Siddhu-123/ai-designed-3d-glasses-clipon/prompts/original_prompts.md

# My original prompts (curated)

Every prompt I typed for this project, oldest first, numbered as in my private log. Two parallel sessions received the same prompt early on; duplicates are merged. Prompts for an unrelated side project are left out, local paths are shortened and strong language is masked. Nothing else is edited, typos included.

**[1]** `2026-10-01T13:39`

> use blender and open the refined.blend file, you will see three pictures of the eyewear, and also a wire mesh. I just want to create that glasses in 3D with proper curvature and all, so that I can create a 3D model of my glasses exactly like my glasses. Use the images for proper alignment and don't f*** up my original model. I also have a mobile LiDAR scanned model of my glasses front, so yeah, that's what I want it to be polished and well structured I want the structure to be spot on. If the plane is flat in the images, I want the 3D model also have the place flat, so do whatever you can, but do best quality. Also, do it with less usage. This is the whole message I am going to give you. I want you to do complete it in this one message

**[2]** `2026-10-01T14:06`

> the bezier curve is what i manually created

**[3]** `2026-10-01T14:29`

> no i dont want you to build the glasses from the lidar scan i want you to create the glasses from the images from all three axes

**[4]** `2026-10-01T15:16`

> so how hard is it to align the glasses with the images? you can clearly see how much difference is there so why cant you sculpt it properly

**[5]** `2026-10-01T15:58`

> you're almost there continue optimising

**[6]** `2026-10-01T16:22`

> what is the alignment accuracy ? i feel like we are almost 80% so do that and do even more finetuning and bring the glasses 100% . something to assume is my photo is not 100% 90deg accurate when taking the images of the glasses so you dont need to think that you are not able to match it. you can alter the image angle such that the image is aligned to the model cause it can be 1 or 2 degrees off. my concern is the front of the glasses i want to create attachments for it so i need that accuracy.

**[7]** `2026-10-01T16:46`

> remove unnecessary files in the folder so much c**p

**[8]** `2026-10-01T16:58`

> see the screenshots pasted with highlighting adjustments

**[9]** `2026-10-01T17:28`

> ok this is good now remove all other files or backups

**[10]** `2026-10-02T08:34`

> i am happy with the glasses_refined.blend but i want a 3d printing ready format export so i see if it is coming the way i wanted also how do we know if we scaled it correctly with the real work size? and i still need to create an attachment to it for making my 3d glasses

**[11]** `2026-10-02T08:49`

> the inside plastic is chapped different compared to the outside looksso i think we need to manually design it "…/dev/blender_ai/IMG_7899.JPG" ,"…/dev/blender_ai/IMG_7900.JPG" i sent the filamnets indide the 3d glasses an the size comparison. also note the white red attachments on the filamnets are my experiment using coke tin cans so i can attach the filament directly on my glasses using aluminium bending flexibility but its spoilling the filament when i use super glu to attach the attachments to the filament so i disgarded the project. s mind the red white thing and dont think its a part of the filament

**[12]** `2026-10-02T09:16`

> "dont put holes  for magnest just put leave it like that i still need to find magnets and their size tells me how much indent is needed to place the magnet and stick it to the frame and cover it with 3d printing (like i will stop the 3d printer at the correct time and place the magnets and let it continue the printing so the magnets stay inside the frame. dont put holes i want a frame that can let me put the filament efforlessly  like it should support indentations inside the frame curvature that support filament to slide in and place the filament ", '…/dev/blender_ai/Screenshot 2026-10-02 at 18.40.57.png'

**[13]** `2026-10-02T09:34`

> so i want to see how to check stress points of the model and if i place the magnets inside the frame can the frame be able to sustain cause we will need to remove as well? so that force should repi my frame due to the magnets so we should see if we can think of all that and choose magnets based on their pull force and where to place them. check for flat surfaces on the frame suggest where to place the magnets and also make sure the frame wont take more space from vision. give me a detailed analysis of  all of this i found this website"https://magnet.com.au/collections/shop?q=magnets" so we can buy magnets and decide what type of magnets we should buy and all. find me the best deal

**[14]** `2026-10-02T09:54`

> did you place this frame on the main glass model and see how much view i am loosing and how thin the frame sides and bottom are getting ? place it on the blender file i will inspect done create another stl wait until i say

**[15]** `2026-10-02T10:17`

> i think you are getting the filament size wrong please cross check and show me if you correctly the dimension correct? because the glasses are correct dimension but the frame looks bigger and the filament cavity is really big than the filament itself so how are we planing to place the filament inside the area we need to place the filament. create a film sheet with its correct dimensions and show me how it fits inside the frame.see these relative size comparison sorry the outline is not good so i sent you the film seperately so see how it compares ith the glasses

**[16]** `2026-10-02T10:24`

> now that you got the film so place that film you generated on to one of the photos i sent "…/dev/blender_ai/IMG_7904.jpg" and check if it did a good job ?

**[17]** `2026-10-02T11:35`

> I found a new 3-D classes frame and bigger lenses, so I also added a 10 cents Australian coin for reference to see the size and measure the millimetre accurate dimensions of the film and the glasses"…/dev/blender_ai/IMG_7905.JPG" redo the 3D frame render, adjust with this new dimensions and give me a STL file and all the analysis of how much like, like, do all the magnet placing part frame correction size correction, all of that, even the perspective correction, everything and give me the blender file so that I can see how it looks from the frame, like when the frame is added, also do the stress testing, what magnet should I put with what length, like what size do all that

**[18]** `2026-10-02T12:12`

> you can omit the old film related stuff

**[19]** `2026-10-02T12:13`

> even the pictures,stls,visualizations all of it remove

**[20]** `2026-10-02T12:16`

> are you sure you removed every thing?, also are you sure the real outline of the film and the shape you showed in this comparison correct? are we comparing both the films? are considering the extra indent too

**[21]** `2026-10-02T12:27`

> why the template we are not cutting the film we will use the existing film as it is in the frame so design the frame accordingly

**[22]** `2026-10-02T13:03`

> I didn't ask you to remove the V2 version, which with cutting the film simulation, because this thing I think it's protruding so much into the glasses that it's disturbing to see. Also, I already shared you how this 3D glasses structure works. I think you have that reference as well. see, analyse that and then tell me if it really extrudes that much"…/dev/blender_ai/IMG_7905.JPG"

**[23]** `2026-10-02T13:26`

> Can you give me a range or approximation of the magnet stats so I can start searching for magnets and find better deals? Also, I only want to buy one size of magnet and place it on the frame text me that one magnet size that has better pull strength, whatever we need, like that

**[26]** `2026-10-02T14:03`

> organize the repo its so confusing which is which

**[28]** `2026-10-02T15:15`

> is the final frame design ready for 3d printing did you satify all my needs?

**[30]** `2026-10-02T15:32`

> i bought the 4mm x 1mm with a 172g of pull force

**[32]** `2026-10-02T15:39`

> in other folders, there are so many other comparison type of PNGs. What are they, and then why are they not there in this new flash 4X one folder? Generate them and I don't want to cut the film that much because it is a really big one, and I don't want to limit the size it is giving me to utilise, it's okay even if it is bigger than the lens, but it shouldn't be uncomfortable for my nose. That's all I'm trying to see

**[34]** `2026-10-02T16:00`

> …/dev/blender_ai/clipon_v2/flush_4x1/clipon_v2_flush_4x1_layout.png

**[36]** `2026-10-02T16:26`

> place the magnets in places with better padding i think you have more space if you move it a bit"…/dev/blender_ai/clipon_v2/strong_4x1/clipon_v2_strong_4x1_layout.png" i think this we can do, and also on the underside of the frame we can add the base cause any way we cant see beyond the glass frame so the scribbled area can be closed and the film can be even secured and more strength can be added.

**[38]** `2026-10-02T16:51`

> i think in the process of doing all of these adjustments i think you lost accuracy on the base glasses see this shape difference and plane no aligned with the real glasses center piece,"'…/dev/blender_ai/clipon_v2/strong2_4x1/Screenshot 2026-10-03 at 02.19.10.png'" check

**[40]** `2026-10-02T16:55`

> see the shape difference two spikes that is enough to the frame to not work properly i want you to adjust that and create the glasses aligned first and also redo everything for the revised frame with the new glasses structure this time it should work flawlessly mind the small errors too

**[42]** `2026-10-02T17:42`

> continue

**[44]** `2026-10-02T18:53`

> "'…/dev/blender_ai/clipon_v2/aligned_4x1/Screenshot 2026-10-03 at 04.22.30.png'" why this gap? any reasoning ? you kept it even tho you know thats visible from your analysis ? you want to waste my time and tokens?

**[46]** `2026-10-02T20:31`

> overwrite the blend file once please

**[48]** `2026-10-02T20:51`

> the magnet hol is like slanty cylinder i dont think whats how a magnet hole should be ??"'…/dev/blender_ai/clipon_v2/aligned_4x1/Screenshot 2026-10-03 at 06.05.46.png'" because when you place the magnet how will it rest if thats the hole direction. also there is so much bad surfaces rough and not clean please smoothen "'…/dev/blender_ai/clipon_v2/aligned_4x1/Screenshot 2026-10-03 at 06.13.13.png'"and make the frame well designed and also do all the checks and make no mistakes why are the holes visible from outside i want them covered only visible from the back and i didnt ask for the frame to follow the shape of the glasses on the front face with bevels we can create no obstruction and yet increase the frame thinkness like "'…/dev/blender_ai/clipon_v2/aligned_4x1/Screenshot 2026-10-03 at 06.16.22.png'"i dont want the bevel to be huge but just so the magnets wont look like these and inside the frame not shown outside. and clean the frame surface and make mesh look polished.

**[50]** `2026-10-03T07:44`

> Try again

**[52]** `2026-10-03T08:16`

> I think I saw some stress points on the frame near the middle and the edges. Should we increase the filament and add bridges to it, like support structures? I don't know, you suggest meI think I saw some stress points on the frame near the middle and the edges. Should we increase the filament and add bridges to it, like support structures? I don't know, you suggest me@clipon_v2/polished_4x1/clipon_v2_polished_4x1_thickness.png

**[54]** `2026-10-03T08:21`

> @clipon_v2/polished_4x1/clipon_v2_polished_4x1_pocket_sections.png I want this kind of analysis or visualisation on the inner linings of the frame to place the film. I mean about the groove and what is the method we are using to place the film and it's not so easy to put it into the frame I think if we don't have a way to do that, suggest me ways

**[56]** `2026-10-03T09:16`

> I think one more thing you need to understand that is I actually don't want to bend the film, so it's a flat film and I can't bend it, so so I think you need to make it in such a way that it doesn't need to be banded and also try to, since I think you'll have more area to work on because the field of you shouldn't be covered, I think you can, yeah, I mean you can use the larger area of the lens properly now, because the film can't be banded because it's it's designed like that. It's not that bending because it'll form deformities if I bend it in the picture

**[58]** `2026-10-03T09:16`

> The app was quit while you were working. Please continue from where you left off.

**[60]** `2026-10-03T10:09`

> I am okay with linear bend in any direction, but double like 3-D bend, how do I say, bending the lens in one direction like in one horizontal direction is fine, but bending it like a dome is not something workable

**[62]** `2026-10-03T10:17`

> the film is thinner than the lines on the ruler so guess its size and also go ahead but also use agents hub to minimize the load cause the usage limit is racing to its finish line. i am going out please complete al the task by the time i get back

**[64]** `2026-10-05T09:40`

> Your usage limit is reset now, so basically I gave some work for ChatGPT to do. I really am disappointed with ChatGPT. It really did the worst job, so see what's new and take the prompts I gave to ChatGPT and try to improve

**[66]** `2026-10-05T15:07`

> use agentshub to remove unnecessary folders or old projects by making detailled report with what assemptions i have while improving and what issues i found in the process how we solved. and how much compute we used for this project thoughout all the harnesses and what is the timeline imrpovements listed and all the features we encorporated for visualizations and what dev techniques and strategies used for searching bugs and resolving the issues. all of it using agentshub give this task to antigravity opus 5.5 and also update the agentshub with your name with a different id or that method of identifying the model cause when i entered claude opus 5.5 for antigravity it starter altering yours cause both have the same model ids but different harness so want a solution for this problem and ask someone else to solve them you just handover work reduce output tokens this week my first proirity is claude code limits i have big project coming so use other harnesses efficiently and be less verbose not less quality.

**[68]** `2026-10-12T14:37`

> is the frame ready ?

**[70]** `2026-10-12T14:43`

> if the previous versions have nothing useful to the future versions just remove the heavy files and leave the knowledge and logs or reports and delete everything else.

**[72]** `2026-10-13T03:57`

> are you sure? made sure all the parameters are considered and calculated? cause the magnets i bought felt not that strong but the manufacturer says its  "Pull Force: 0.172 kg" and also says "
> 
> [pasted manufacturer note about pull-force ratings]

**[74]** `2026-10-13T04:06`

> how did you calculate the clipon weight?

**[76]** `2026-10-13T04:08`

> so can we increase the magnet numbers ? do we have more space on the glass surface  for more magnets so we can get more pull force collectively?

**[78]** `2026-10-13T04:10`

> we only have 4mm x 1mm magnet

**[80]** `2026-10-13T04:12`

> show me where you are placing i will draw and ask why not here so you can explain me

**[82]** `2026-10-13T04:16`

> add a gradient colour to show where i cannot place due to contact issue

**[84]** `2026-10-13T04:20`

> why are we not able to utilize the whole steel area of the glass? most of it is not flat?

**[86]** `2026-10-13T04:22`

> ok just show me a front view and the flatness and depth colour gradient that dipicts the 3d depth on a 2d image i will see how much flatness the magnet can use and stay contact with the glasses

**[88]** `2026-10-13T04:33`

> are using the right clipon cause i can see some defects in the design. look how the areas are not symmetrical ? if you see my glasses you can see the symmetric frame structure. check and lets work on the latest version with no defects

**[92]** `2026-10-13T07:57`

> i placed the magnets on the steel frame of my glasses and i think this is the maximum i can place also stacking one on another these are 20 magnets altogether. so will this compromize on any structural integrity?

**[94]** `2026-10-13T21:04`

> I mean, this is the maximum we can put. I'm saying, so you decide which to remove and which to add so that we'll have enough sticking force force

**[96]** `2026-10-13T21:11`

> Did you check the flat surface, like are the magnets resting on the steel frame?

**[98]** `2026-10-13T21:12`

> Organise the repo and clearly mention the latest version as latest and anything else with proper naming and organise the whole folder repo

**[100]** `2026-10-14T02:07`

> So we are still working on four magnets, isn't it? Do you really think four magnets are enough? There will be enough pulling force.?

**[102]** `2026-10-14T20:00`

> 6 magnets stacked?

**[107]** `2026-10-16T06:10`

> so put the camera at an angle in the blender file so if seen from eye percepective how will it look

**[108]** `2026-10-19T13:20`

> fix the remaining stuff and give the 3d model to all different models and give context of requests i made and all then let them find issues and different percpectives and check all the smoothness and accuracy related tasks to the models to let you fix them and if they are really present and makes sense and align with my goal make the changes

**[111]** `2026-10-19T14:06`

> no never let codex work on your stuff just take use of it and only do it when i say to that too when you are out of tokens

**[113]** `2026-10-19T14:26`

> what are the checks? does it include my comfort? or just it include if my it touches my nose?

**[114]** `2026-10-19T14:28`

> Yes, add a nose-clearance and weight/balance check. I'll send the bridge-to-nose gap (and my glasses' weight if I can).

**[115]** `2026-10-20T00:55`

> i showed you a picture of me and the glasses so you decide how till will impact my comfort if possible create a face structure and place the glasses and see if it might affect me

**[117]** `2026-10-20T01:43`

> clean the repo organize

**[131]** `2026-10-20T11:00`

> if i lay my frame flat on ground at what angles the printing of the frame is the best making sure the that filam holder is not not having steps like this. also are we ready to print the frame?any final tweaks required? and what is the latest stl file mention it the final.stl

**[133]** `2026-10-20T11:15`

> can you be able to control the angle yourself in the ultimaker app? do you have mcp with that app?

**[135]** `2026-10-20T11:20`

> yah do that but try to consume as less of usage as possible

**[137]** `2026-10-20T11:46`

> what happend

**[139]** `2026-10-20T12:15`

> its ok use the usage but see if all the sensitive areas are properly drawn for the print. and the film holder is aligned perfectly? look there are some very thin sections that are indicated with white colour i think we need to see if they will print properly or not check all these combinations and tell me if anything needs changes

**[140]** `2026-10-21T00:07`

> look at the white linings really thin i guess why wont you check that?

**[141]** `2026-10-21T03:40`

> you still didnt say why cant we make it flat cause that will filament cost and time will the lineing wont be perfect horizontally?

**[142]** `2026-10-21T04:18`

> alright you are right lets do it upright

**[143]** `2026-10-21T04:55`

> so all scenarios and all checks done. just wondering what are all the testing possibilities have you thought of and was so confident to send for printing cause i only have one shot to print and i dont want to ruin it or overlook issues. is the scale proper? how are we checking with that? i sent you images and a 3d model scan and a size comparison using 10c aud

**[144]** `2026-10-21T05:23`

> first one is a 120mm 12mp , 2nd one is 24mm 48mp i have included 10sen malaysian coin, regular stapler pin a less accurate wooden scale and a square grid paper with i think 6mm squares and the glasses facing down folded arms. check how well the current frame is perfectly fits to the glasses

**[146]** `2026-10-21T07:20`

> i gave the coins because they are well known you can look up in the internet to get exact measurement for more precision. i want this precision 2.345mm kindof

**[147]** `2026-10-21T07:43`

> i found this is a perfect 6mm square grid paper so i think you can rely on this go ahead. with v15

**[148]** `2026-10-21T08:35`

> Don't be early. Last time you said the same, but see how I found an issue from yours. Now, how are you confident that this is gonna be the best version and it's perfectly gonna work?

**[149]** `2026-10-21T08:54`

> Show me the visuals so I can understand how, what do you mean difference and why do you need this extra data and forget about the film thickness? I think it's 0.2 MM and the only thing you need to care is I gave you so many pictures of the glasses, so use them properly to assess the 3-D shape and 1% differences is fine, like at least till 5% is fine, I guess. I think I can use some heat gun to over a hairdryer to somehow fit properly, but make sure everything else is done from your side and printer tolerance I need to check, I don't know what printer I am trying to print. I will let you know once I know the actual printer name, but for no like whatever you assume, that's fine only care about the worst parts where so much difference is there. like 1.4 MM is still fine, but if it is on the side where it covers the glasses view, then it's the problem if the perimeter of the glass which I look out is not disturbed, then I don't have any problem. So look at such things and tell me or give me the final STL file so that I can pla in the Quran, show you, and then you can decide what orientation is good and if the final G code is perfect

**[150]** `2026-10-21T11:59`

> So, so that's what I'm trying to ask you, like show me the comparison between the photo items and then the current model. Show me the correct fit, how much is it really lacking or where it is distorted or whatever it is

**[151]** `2026-10-21T12:05`

> so why are we cropping the R? Is there not enough film to completely be visible to my glasses size? Is that not enough? Can you compare the glass and the film and show me what is cut off from the film?

**[152]** `2026-10-21T12:18`

> TheThe ones you areThe ones you're showing showing is theThe ones you're showing is the latestThe ones you're showing is the latest photos.The ones you're showing is the latest photos. I I gaveThe ones you're showing is the latest photos. I gave you themThe ones you're showing is the latest photos. I gave you toThe ones you're showing is the latest photos. I gave you them to, you know, basicallyThe ones you're showing is the latest photos. I gave you them to, you know, basically checkThe ones you're showing is the latest photos. I gave you them to, you know, basically check theThe ones you're showing is the latest photos. I gave you them to, you know, basically check the sizeThe ones you're showing is the latest photos. I gave you them to, you know, basically check the size. It's basically I haveThe ones you're showing is the latest photos. I gave you them to, you know, basically check the size. It's basically I have given youThe ones you're showing is the latest photos. I gave you them to, you know, basically check the size. It's basically I have given you aThe ones you're showing is the latest photos. I gave you them to, you know, basically check the size. It's basically I have given you a bezierThe ones you're showing is the latest photos. I gave you them to, you know, basically check the size. It's basically I have given you a bezel curveThe ones you're showing is the latest photos. I gave you them to, you know, basically check the size. It's basically I have given you a

**[153]** `2026-10-21T12:23`

> I don't know what and all you f***ed up. I want you to check the whole versions list and see whatever you f***ed it up and tell me what you f***ed it up from the original because you know, you are allowed to take creative decisions but you should not be dumb at taking them right when I said or manually slogged my a** drawing those outlines for you, how come you f*** it up again? It's okay, just go back in time and see what and all you experimented without me telling you can say you are right and I am wrong, but what will you do if you know after I print and that's the only chance I have, you are so confident when you are just talking but you are actually not, you're just hallucinating that you are confident. You're not actually fact checking, it's just blabbering words telling that yeah, yeah, yeah, I'm, it's great, you can continue. What the f*** is that? I want you to properly scale the model to the glasses you have the data, you know how how big is the model in the blend file and I showed you a picture of my glasses side next to the coins and on a 6 MM square sheet. Now you know everything you have, actually you have everything to measure properly now. So what's stopping you? Go to I want a concise explanation at the end after you do all of that. Give me a proper result. how much sure are you that whatever the final STL file you're giving that it's gonna be perfect or 1% bad where it is bad, how it is not aligned properly? I want that kind of information. I did what you as

**[154]** `2026-10-21T12:57`

> use gpt 6.1 its literally free

**[155]** `2026-10-21T13:34`

> use this i tried to make it as flat as possible so try see how it is matching with this you are seeing the front view but from top. for other angle i sent you another image from the side. i think you can get the angle using the grid worping. so do your magic

**[157]** `2026-10-22T02:34`

> on the glasses arm there are some numbers so how will they help us?

**[159]** `2026-10-22T02:41`

> i think the website has a better picture that you can use "https://www.specsavers.com.au/glasses/dylan-plus?sku=34074244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"

**[161]** `2026-10-22T03:04`

> its this not the before one""

**[162]** `2026-10-22T03:06`

> no not just the colour difference the shape of the glasses itself is difference

**[163]** `2026-10-22T03:07`

> [Request interrupted by user]

**[164]** `2026-10-22T03:08`

> i mean i dont understand know that you know the actual shape and scale why can we go for v19 and get perfect results?

**[165]** `2026-10-22T03:13`

> so know we know the perfect model of our glasses so how is our frame doing with the surface contact and the fit quality cause that will. impact the magnets pull force and i dont like if we endup with a loose frame that falls of my glasses while seeing the movie

**[166]** `2026-10-22T06:29`

> Sometimes I feel like you forget what you did previously, because I showed you pictures of magnets on the frame itself. Why do you think that it will be not magnetic

**[167]** `2026-10-26T07:35`

> make it final and give me the final thats it just do all of it

**[168]** `2026-10-26T08:10`

> clean and organize the folder. do version control and leave important information and images for flow overview

**[169]** `2026-10-26T08:20`

> why is there issues in the comparisons how are you saying there is no that difference ??

**[170]** `2026-10-26T08:23`

> Don't scare me, buddy. I've already given the steel files for my friend to print. Don't say that everything is wrong. Like, how can you be so irresponsible and just blabber out stuff that you don't even are sure about? I've asked plenty of times. How do I have to believe you are like consider your suggestions? Like, how wrong could you be?

**[171]** `2026-10-26T08:25`

> Look, I need all the analysis done for the final version. Give me every, every single analysis graphs, plots, whatever it is you have done for other models or like other versions. I need every single analysis done on the each part coming from shape fit durability magnets positions, whatever it is. I need everything to be done and placed in the final_v15 folder

**[172]** `2026-10-26T08:44`

> So after all that analysis, don't you think anything needs to be changed?

**[173]** `2026-10-26T08:52`

> add the blend file to the final folder

**[174]** `2026-10-26T13:22`

> if you are struggling with drawing the outline you should let me know right? look at this film cut i thought you are cropping it because it is causing issues with the magnet placement but looking at the blend file this purly your incapacity to draw simple outline around a film and because of that now the user (me ) should suffer cutting the film in this complex shape to fit properly. what is this claude its not fair

**[175]** `2026-10-26T13:55`

> now who will fix the frame? it has this weird curves design

**[176]** `2026-10-26T13:57`

> update all the final files

**[177]** `2026-10-26T14:22`

> all the checks done fit, smooth, design, look, size? all

**[178]** `2026-10-26T14:26`

> make reports for all the versions instead of individual files create a version report structure and create reports for each and every version tell what has been achieved in that version and what is lacking and my prompts linked those versions in a seperate section. use multiple haiku models as subagents and complete the task
