Siddhu-123/ai-designed-3d-glasses-clipon/report/AI_Engineered_3D_Clipon_Report.pdf

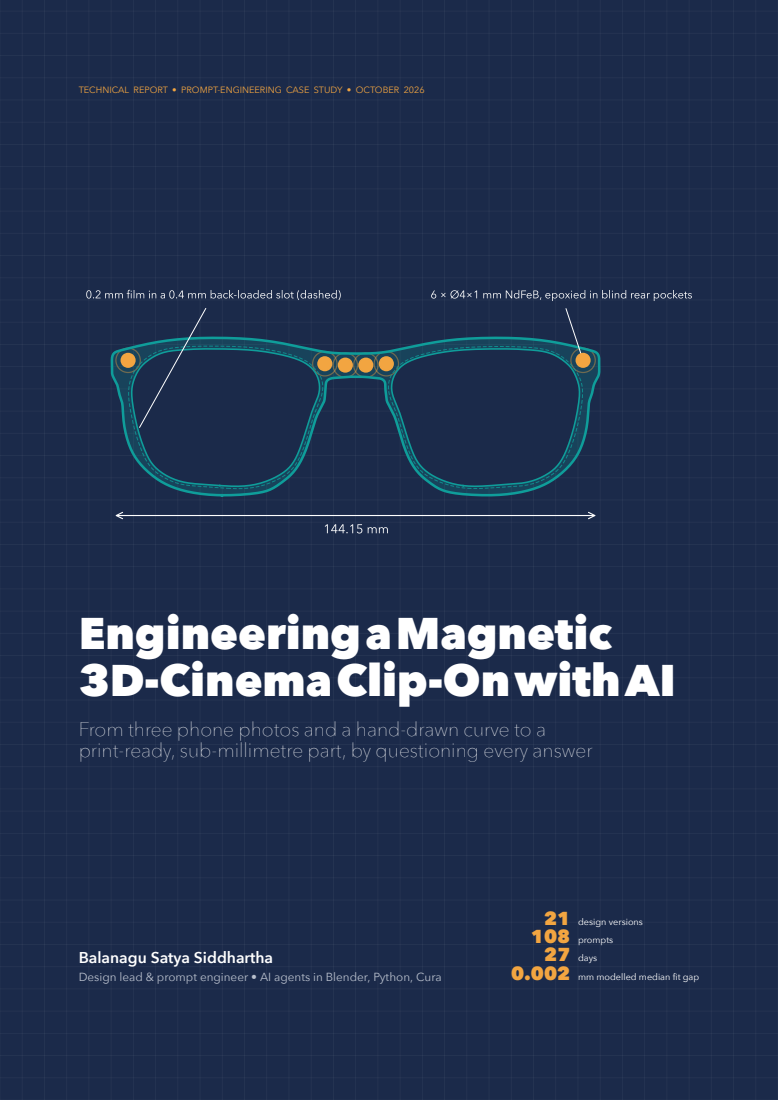
[picture p35: page 1]
0.2 mm film in a 0.4 mm back-loaded slot (dashed); 6 × Ø4×1 mm NdFeB, epoxied in blind rear pockets; TECHNICAL; REPORT •; PROMPT-ENGINEERING CASE; STUDY •; OCTOBER; EngineeringaMagnetic 3D-CinemaClip-OnwithAI

From three phone photos and a hand-drawn curve to a
print-ready, sub-millimetre part, by questioning every answer

21 design versions
108 prompts
27 days
0.002 mm modelled median fit gap

Balanagu Satya Siddhartha
Design lead & prompt engineer • AI agents in Blender, Python, Cura

MAGNETIC 3D-FILM CLIP-ON • AI-ENGINEERED | At a glance

# At a glance

I wear prescription glasses with a thin steel frame. Passive 3D cinema glasses do not fit over them comfortably, so I set out to build a 3.3-gram clip-on that holds the polarised film from cheap 3D glasses directly on my own frame, held by magnets. I did not draw it in CAD. I directed AI agents to build it in Blender through code, and I spent most of my effort on asking the right questions, supplying real-world evidence, and refusing to accept confident answers that were not backed by a measurement.

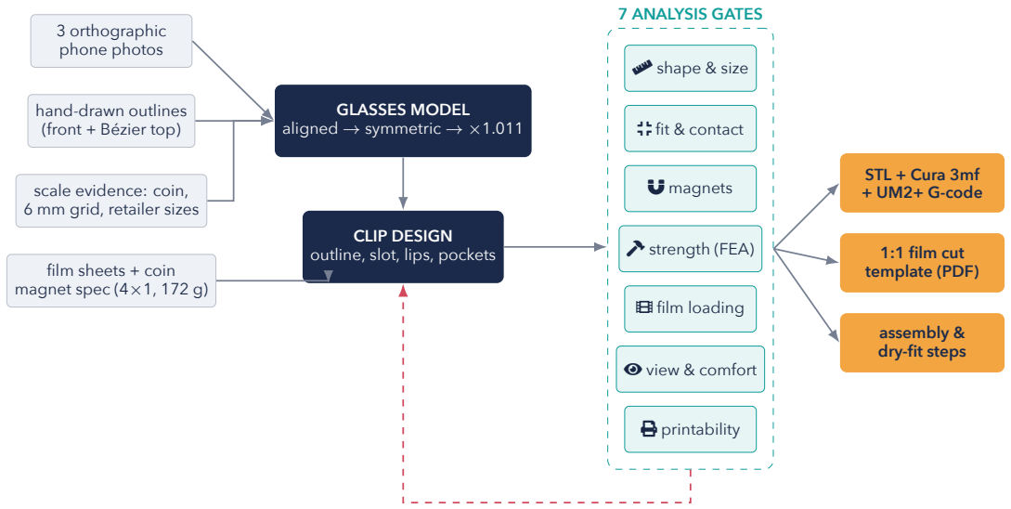
[picture p36: figure]
3 orthographic phone photos; hand-drawn outlines (front + Bézier top); scale evidence: coin, 6 mm grid, retailer sizes; film sheets + coin magnet spec (4×1, 172 g); GLASSES MODEL aligned → symmetric → ×1.011; CLIP DESIGN outline, slot, lips, pockets;  shape & size; · fit & contact; Æ magnets;  strength (FEA); j film loading; ¿ view & comfort;  printability; 7 ANALYSIS GATES; STL + Cura 3mf + UM2+ G-code; 1:1 film cut template (PDF); assembly & dry-fit steps

any gate fails or I find a defect ⇒ new version

Figure 1 The whole system on one page. Four kinds of real-world input feed a parametric glasses model and a clip design written as Python for Blender; every version must pass seven analysis gates before any print file is written. A failed gate, or a defect I spotted, produced a new version.

What this repository shows.
- Me: how the idea started, how I framed the problem, how
I questioned the AI and steered 21 versions to a final part.
- Method: an evidence-first way of engineering a physical object with AI agents, with no CAD skills required.
- Playbook (Part II): prerequisites, steps and copy-paste prompts so anyone can do the same for their glasses, including frames that are not magnetic.

Honest status (27 Oct 2026).
- Final design: v15.1, print files ready, sliced for an Ultimaker 2+ (2 h 9 min, 0.27 mm first layer then 0.1 mm).
- Not yet verified on the real glasses: the dry fit and the real magnet pull. Section 8 is reserved for the results once the part arrives.
- Hold, strength and comfort numbers are model estimates, labelled as such.
B. S. Siddhartha • October 2026 | 2

MAGNETIC 3D-FILM CLIP-ON • AI-ENGINEERED | Contents

# Contents

I The engineer: how I approached it | 4
1 The problem and how the idea started | 4
2 My approach: principles I set for the AI | 5
3 The iteration journey | 6
4 How I questioned the AI | 7
5 Engineering with AI: orchestration | 11
6 Verification: seven gates | 12
7 The final design | 17
8 Open items and field results | 18
II Community playbook: build one for your glasses | 19
9 Before you start | 19
10 The procedure in ten steps | 20
11 Prompt pack | 21
12 If your frame is not magnetic: clamp from all sides | 22
13 Lessons for the community | 22
A Version ledger | 23
B Reproducing the figures | 23
B. S. Siddhartha • October 2026 | 3

MAGNETIC 3D-FILM CLIP-ON • AI-ENGINEERED | 1 The problem and how the idea started

# PART I

# The engineer: how I approached it

# 1 The problem and how the idea started

## 1.1 The problem

Cinemas hand out passive polarised 3D glasses. Worn over prescription glasses they slide, press on the nose, tilt the film away from the eye and fog up. Commercial clip-on 3D lenses exist, but they are generic: they clip over the lens with sprung arms, cover part of the view and rarely match a specific frame. I wanted something that disappears onto my frame: same outline, no visible hardware, the full lens area used and nothing touching my face.

## 1.2 The first attempt that failed (and taught me the constraints)

Before using AI at all, I tried a physical hack. I cut the two film sheets out of a pair of cinema 3D glasses, folded strips of aluminium from a Coke can into hooks and glued them to the film so it could hang on my frame. The aluminium bent nicely, but the super glue spoiled the film. That failure gave me three hard constraints that shaped everything later:
1. The film is fragile: no cyanoacrylate (super glue) near it, since its fumes fog the polariser. Only 2-part epoxy, and only far from the film.
2. The film must stay flat: it can bow in one direction, never dome (I made this explicit to the AI in prompts 56 and 60).
3. The attachment must not rely on bending metal by hand; it must be repeatable and precise.

i PROMPT [11], 2 Oct
the white red attachments on the filamnets are my experiment using coke tin cans so i can attach the filament directly on my glasses using aluminium bending flexibility but its spoilling the filament when i use super glu to attach the attachments to the filament so i disgarded the project.

## 1.3 The idea: let the frame itself be the fixture

My glasses have a stainless-steel front. Steel is magnetic, so the frame can be the fixture: a thin printed carrier holds the film, and tiny neodymium magnets in hidden pockets on its back snap onto the rims. Nothing touches the lens, nothing clamps, and it comes off with a peel. I later tested this assumption by sticking 20 loose magnets on the rims (13 Oct) to find where they hold and how many fit.

B. S. Siddhartha • October 2026 | 4

MAGNETIC 3D-FILM CLIP-ON • AI-ENGINEERED | 2 My approach: principles I set for the AI


Figure 2 The only raw inputs at the start: three phone photos of my glasses (front, side, top not shown) and the two film sheets next to a 10-cent coin for scale.

# 2 My approach: principles I set for the AI

I treated the AI as a fast, tireless engineer who is overconfident and occasionally forgets. My job was to set the rules of the game, feed it ground truth and audit its claims. These principles emerged in the first days and I enforced them for the whole project.

the side photo. Later photos may set size,

“Are you sure?” is a request for a number, a plot or a section view. A claim without a

I have one chance to print. Every risk the

Coins, 6 mm grid paper, retailer sizes, the

Each version keeps its folder and report.

## 2.1 Breaking the problem down

Before any clip existed I insisted on a correct glasses model, because every later number (contact, magnet seating, view) is measured against it. The problem then decomposes into six coupled sub-problems. The difficulty is the coupling: moving a magnet changes the wall thickness, the film slot, the clear view and the hold at the same time.

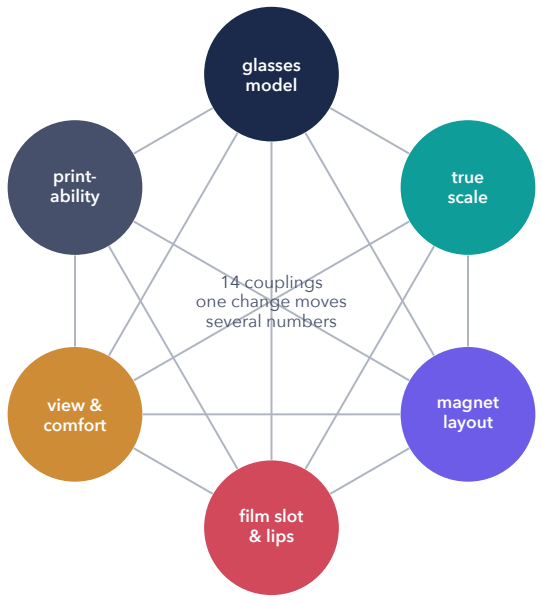
[picture p37: figure]
glasses model; true scale; magnet layout; film slot & lips; view & comfort; print- ability; 14 couplings one change moves several numbers

B. S. Siddhartha • October 2026 | 5

MAGNETIC 3D-FILM CLIP-ON • AI-ENGINEERED | 3 The iteration journey

# 3 The iteration journey

The project ran from 1 to 27 October 2026. Figure 3 shows every version, how long it lived and how many of my prompts drove it. The large dot on v00 is telling: about a third of the version-linked prompts went into the

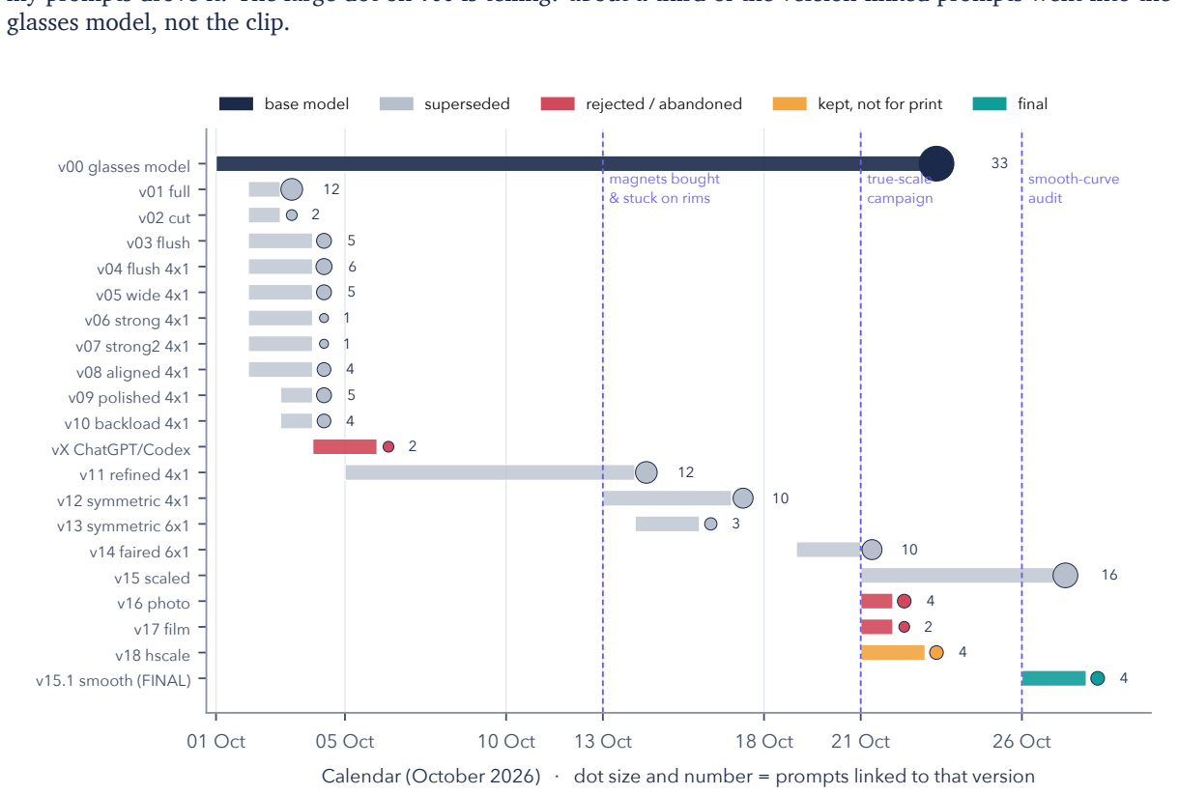
[picture p38: figure]
glasses model, not the clip.; 01 Oct; 05 Oct; 10 Oct; 13 Oct; 18 Oct; 21 Oct; 26 Oct; v00 glasses model v01 full v02 cut v03 flush v04 flush 4x1 v05 wide 4x1 v06 strong 4x1 v07 strong2 4x1 v08 aligned 4x1 v09 polished 4x1 v10 backload 4x1 vX ChatGPT/Codex v11 refined 4x1 v12 symmetric 4x1 v13 symmetric 6x1 v14 faired 6x1 v15 scaled v16 photo v17 film v18 hscale v15.1 smooth (FINAL); magnets bought & stuck on rims; true-scale campaign; smooth-curve audit; base model; superseded; rejected / abandoned; kept, not for print; final

Calendar (October 2026) · dot size and number = prompts linked to that version

Figure 3 All 21 design versions on the calendar. Bars span first to last work; colour gives the final status. Purple lines mark the three turning points.

## 3.1 Seven phases

A
model

B
v01–v07

C
v08–v11

D
v12–v13

E
v14

F
v15–v18

G
v15.1
Phase | What happened and what I pushed for
A Glasses model (1–2 Oct) Built from photos on three axes, not from the LiDAR scan. I told the AI my photos may be
| 1–2◦ off-axis and it may rotate them; I pushed alignment from “about 80%” to tight.
B First clips v01–v07 | Uncut film, cut film, flush outline, 4×1 mm magnets (after I bought them), wider borders,
| magnets moved to spots I sketched. Nose collision drove most changes.
C Aligned model v08–v11 | I spotted two spikes where the model drifted from my real centre piece ⇒ rebuilt the model
| aligned first. Square magnet holes, smooth front, back-loaded film, film traced from the
| two real sheets.
D Magnets v12–v13 | Datasheet pull is for 10 mm steel; on a vertical thin rim it drops to roughly 30%. Mirror-
| symmetric frame. I stuck 20 magnets on the rims; six single magnets chosen.
E Comfort & print v14 | Multi-model review, nose-clearance and face-fit check from my photo, print orientation (up-
| right, after I asked why not flat).
F True scale v15–v18 | “I only have one shot to print.” Grid-paper and coin photos gave ×1.011. A photo-traced
| reshape (v16) broke my outline rule and was rejected; v18 (×1.026 height) kept but not
| printed.
G Smoothing v15.1 | I noticed the film cut was a wiggly trace, not a real constraint. Slot, lips and cut redrawn as
| smooth curves; all checks re-run.
B. S. Siddhartha • October 2026 | 6

MAGNETIC 3D-FILM CLIP-ON • AI-ENGINEERED | 4 How I questioned the AI

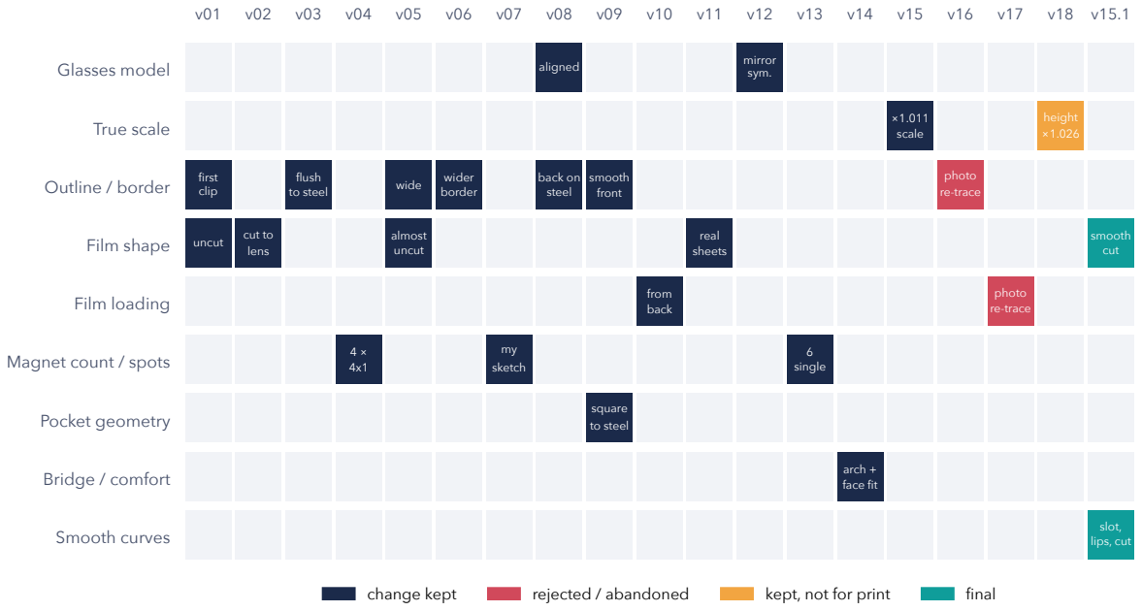
[picture p39: figure]
Glasses model; True scale; Outline / border; Film shape; Film loading; Magnet count / spots; Pocket geometry; Bridge / comfort; Smooth curves; first clip; uncut; cut to lens; flush to steel; wide; almost uncut; wider border; my sketch; aligned; mirror sym.; back on steel; smooth front; square to steel; from back; real sheets; 6 single; arch + face fit; photo re-trace; smooth cut; slot, lips, cut

v01 v02 v03 v04 v05 v06 v07 v08 v09 v10 v11 v12 v13 v14 v15 v16 v17 v18 v15.1

| | ×1.011 scale | height ×1.026
change kept | rejected / abandoned | kept, not for print | final

Figure 4 What changed in each version. From the front the versions look almost identical; the engineering happened in tenths of a millimetre in the attachment, fit, film slot and scale. Each coloured cell is a change and its trigger; Section 6 shows the checks behind them.

# 4 How I questioned the AI

## 4.1 The anatomy of my prompts

I classified all 108 project prompts by intent (classification by a second model, checked by a script). Figure 5 shows when each kind of prompt happened. Only one prompt stated the goal; 58 of 108 (54%) were about checking rather than building: 25 asked for a verification, 17 corrected a specific defect and 16 challenged a claim. They cluster at the turning points (2–3 Oct, 21 Oct, 26 Oct): I usually caught a problem first, then forced a new version.

## 4.2 The challenge loop

Most of my progress came from one repeated loop. The AI made a confident claim; I asked for a visual or a number; I found what was wrong in it; the finding became a permanent rule; the AI rebuilt; a gate checked the rule from then on.

B. S. Siddhartha • October 2026 | 7

MAGNETIC 3D-FILM CLIP-ON • AI-ENGINEERED | 4 How I questioned the AI

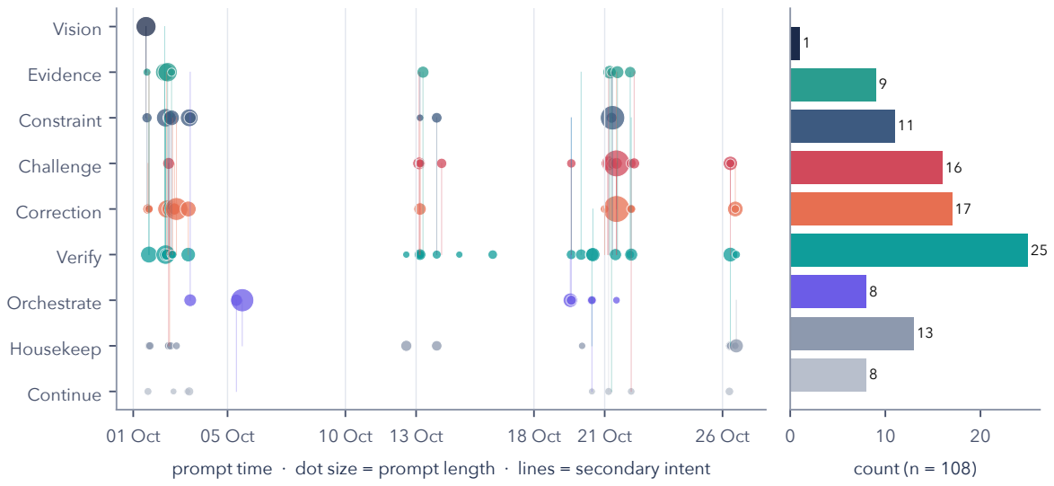
[picture p40: figure]
01 Oct; 05 Oct; 10 Oct 13 Oct; 18 Oct 21 Oct; 26 Oct; Vision; Evidence; Constraint; Challenge; Correction; Verify; Orchestrate; Housekeep; Continue; count (n = 108)

prompt time · dot size = prompt length · lines = secondary intent

Figure 5 Every prompt as a dot on the calendar, by primary intent; thin lines join a secondary intent. Right: totals.

## 4.3 Case studies

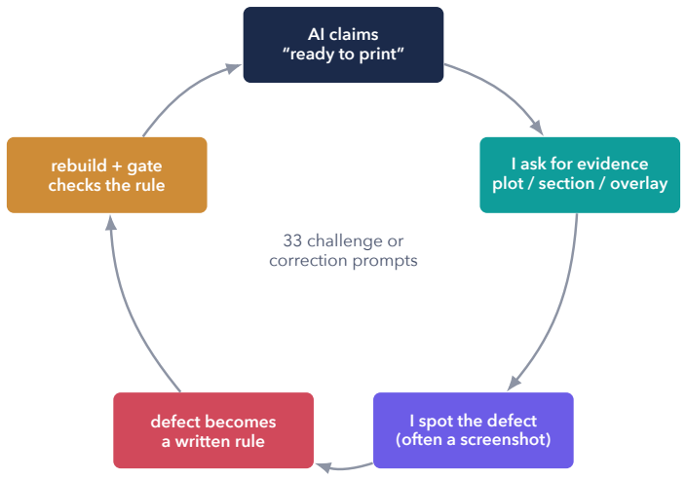
[picture p41: figure]
AI claims “ready to print”; I ask for evidence plot / section / overlay; I spot the defect (often a screenshot); defect becomes a written rule; rebuild + gate checks the rule; 33 challenge or correction prompts

1. “Why this gap?”: refusing a known defect

i PROMPT [44], 3 Oct
why this gap? any reasoning ? you kept it even tho you know thats visible from your analysis ? you want to waste my time and tokens?

¬ WHAT IT CAUGHT The AI’s own contact analysis already showed the gap between clip back and steel. It had reported it instead
of fixing it. The clip back was rebuilt from the true steel surface
(v08). Since then the rule is: never present a fit with a flaw the

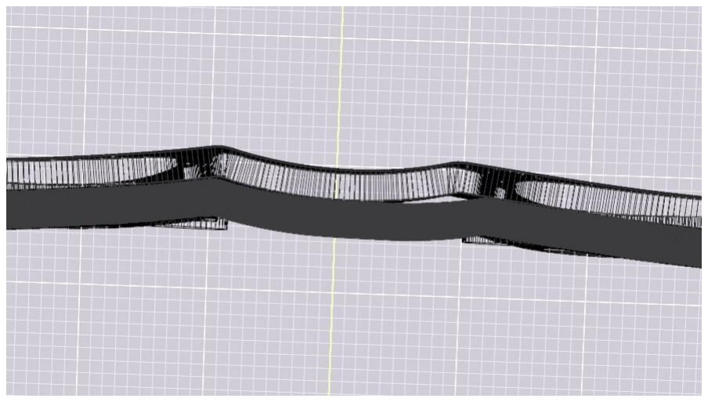
[picture p42: figure]

analysis shows. Final v15.1: modelled median gap 0.002 mm. | My markup on the AI’s render: the visible gap between clip and
| rim.
B. S. Siddhartha • October 2026 | 8

MAGNETIC 3D-FILM CLIP-ON • AI-ENGINEERED | 4 How I questioned the AI

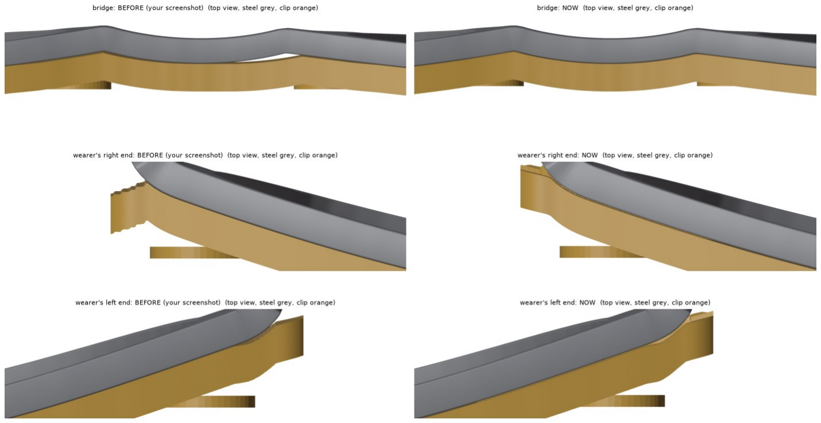
[picture p43: figure]

Figure 6 The gap before and after the clip back was rebuilt from the true steel surface.

### 2. The slanted magnet hole and the hidden bevel

i PROMPT [48], 3 Oct
the magnet hol is like slanty cylinder i dont think whats how a magnet hole should be ?? because when you place the magnet how will it rest if thats the hole direction ... why are the holes visible from outside i want them covered only visible from the back

¬ WHAT IT CAUGHT Pocket axes were tilted to the steel, so a magnet could not sit flat. Pockets were made square to the local steel surface, blind from the front (cover ≥ 0.95 mm, final 1.183 mm), and the front got a gentle bevel I sketched to add thickness without blocking the view.


My sketched bevel profile on the AI’s section.

B. S. Siddhartha • October 2026 | 9

MAGNETIC 3D-FILM CLIP-ON • AI-ENGINEERED | 4 How I questioned the AI


Figure 7 My markup on the AI’s render: the “?” on the slanted pocket that a magnet could not sit in flat.

### 3. Reading the datasheet more carefully than the AI

i PROMPT [72], 13 Oct
are you sure? made sure all the parameters are considered and calculated? cause the magnets i bought felt not that strong but the manufacturer says its “Pull Force: 0.172 kg” [pasted the manufacturer’s note: rated on 10 mm steel, about 30% on a vertical surface, less on thin steel]

¬ WHAT IT CAUGHT The hold model was re-derived with orientation, thin-steel saturation and air gap; I then asked to see where magnets can sit with a depth/flatness map, stuck 20 magnets on my real rims to test, and asked for more magnets. Result: six single magnets (v13), 87–92% of each magnet face over flat steel.

4. “I only have one shot”: the true-scale campaign

i PROMPT [143] and [146], 21 Oct
just wondering what are all the testing possibilities have you thought of and was so confident to send for printing cause i only have one shot to print … i gave the coins because they are well known you can look up in the internet to get exact measurement for more precision. i want this precision 2.345mm kindof

¬ WHAT IT CAUGHT The model’s absolute size had never been proven. I photographed the glasses on 6 mm grid paper with two cameras, a coin, a staple and a ruler. Four independent sources were reconciled (Figure 10); three agreed on ×1.011, which became v15. The one outlier was built as v18 and kept, not printed.

### 5. Holding the AI to my outlines

i PROMPT [153], 21 Oct (strong language masked)
you are allowed to take creative decisions but you should not be dumb at taking them right when I … manually slogged my a** drawing those outlines for you, how come you f*** it up again? … You’re not actually fact checking

¬ WHAT IT CAUGHT v16 had silently reshaped the clip from a photo re-trace, against my rule that shape comes only from my outlines. It was rejected, a full audit of all versions was run, and the rule was written into every later brief.

B. S. Siddhartha • October 2026 | 10

MAGNETIC 3D-FILM CLIP-ON • AI-ENGINEERED | 5 Engineering with AI: orchestration


Figure 8 Top: the steel depth and flatness map I asked for (prompt 86), so I could judge myself where a 4 mm magnet keeps contact. Bottom: the six-magnet proposal (green) against the old four (red dashed).

### 6. The wiggly film cut

i PROMPT [174], 26 Oct
look at this film cut i thought you are cropping it because it is causing issues with the magnet placement but looking at the blend file this purly your incapacity to draw simple outline around a film and because of that now the user (me) should suffer cutting the film in this complex shape to fit properly.

¬ WHAT IT CAUGHT The slot, lips and cut line followed a noisy photo trace (0.1–1 mm wiggles). They were redrawn as smooth curves (v15.1) and every check was re-run. New rule: anything a person cuts by hand must be smooth; odd shapes must be explained up front.

# 5 Engineering with AI: orchestration

## 5.1 The setup

I ran the project with one main model that kept the full context and wrote the Blender/Python code, plus other models for bounded jobs and independent reviews, coordinated by my own orchestration console (Agent Hub). Workers had no Blender in their sandbox, so geometry builds stayed with the main model while analysis scripts, documentation and reviews were delegated.

B. S. Siddhartha • October 2026 | 11

MAGNETIC 3D-FILM CLIP-ON • AI-ENGINEERED | 6 Verification: seven gates

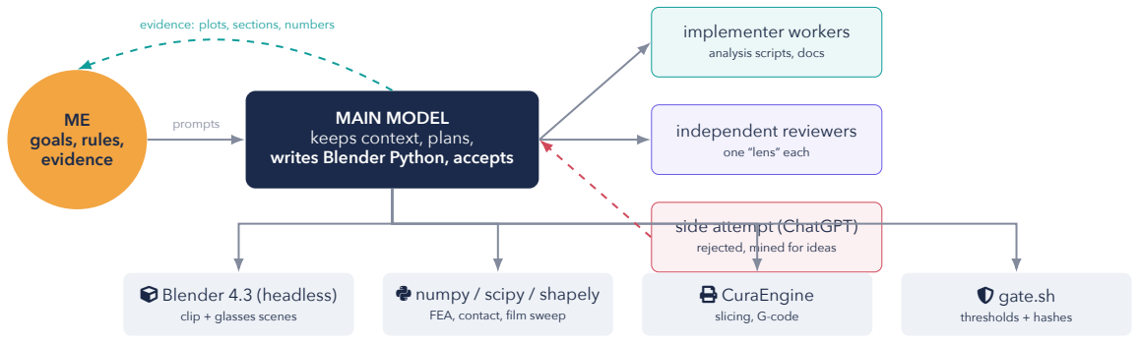
[picture p44: figure]
ME goals, rules, evidence; MAIN MODEL keeps context, plans, writes Blender Python, accepts; implementer workers analysis scripts, docs; independent reviewers one “lens” each; side attempt (ChatGPT) rejected, mined for ideas;  Blender 4.3 (headless) clip + glasses scenes;  numpy / scipy / shapely FEA, contact, film sweep;  CuraEngine slicing, G-code;  gate.sh thresholds + hashes; prompts; evidence: plots, sections, numbers

## 5.2 What I did differently

- Reviews with lenses. For v13 I asked for the 3D model and my full request history to be given to several models, each asked to find issues through one lens (“making and using the real part”, smoothness, accuracy), backed by numbers or file lines. The main model then verified each finding before changing anything (prompt 108).
- Workers are claims, not results. Worker output counted only after a check script passed and the diff was read. One worker’s note said outputs were missing when they existed; it was caught because results were re-derived from the source.
- Budget-aware delegation. I explicitly steered usage (“use agents hub to minimise the load”, “use GPT 6.1, it’s literally free”), and also limited it: no other model edits the main work unless I say so (prompt 111).
- Cross-model comparison. When the ChatGPT side attempt came back (4–5 Oct) I rejected it, then had the main model read its prompts and outputs and improve on them. Its numbers (e.g. 99.8% clear view) relied on a fictional oversized film contour, a good example of a confident but wrong result.
- Everything reproducible. Each version has a build chain (chain.sh), a gate (gate.sh) with numeric thresholds and SHA-256 checks that the protected glasses models are untouched, a report, and my linked prompts.

# 6 Verification: seven gates

Every number below is for the final v15.1 unless noted. Figure 9 puts the critical ones against their thresholds.

0.0 | 0.5 | 1.0 | 1.5 | 2.0 | 2.5 | 3.0
margin = measured / required (final v15.1)

Plastic wall around magnet pocket
Front cover over pocket
Plastic between pockets
Assumed film strain limit vs loading peak Hold vs clip weight (est.) PLA strength vs FEA peak (comparative)

1.183 vs 0.95 mm (1.25×)

1.581 vs 1.4 mm (1.13×)

1 vs 0.898 % (1.11×)

1.9 vs 0.048 N (40×, axis capped)

50 vs 1.4 MPa (36×, axis capped)

required

| 0.997 vs 0.95 mm (1.05×)

Figure 9 Margins of the final design. Thin-wall margins are deliberately small: every 0.1 mm of plastic is 0.1 mm of lost view. Hold and strength numbers are estimates (comparative FEA, typical PLA strength 50 MPa).

B. S. Siddhartha • October 2026 | 12

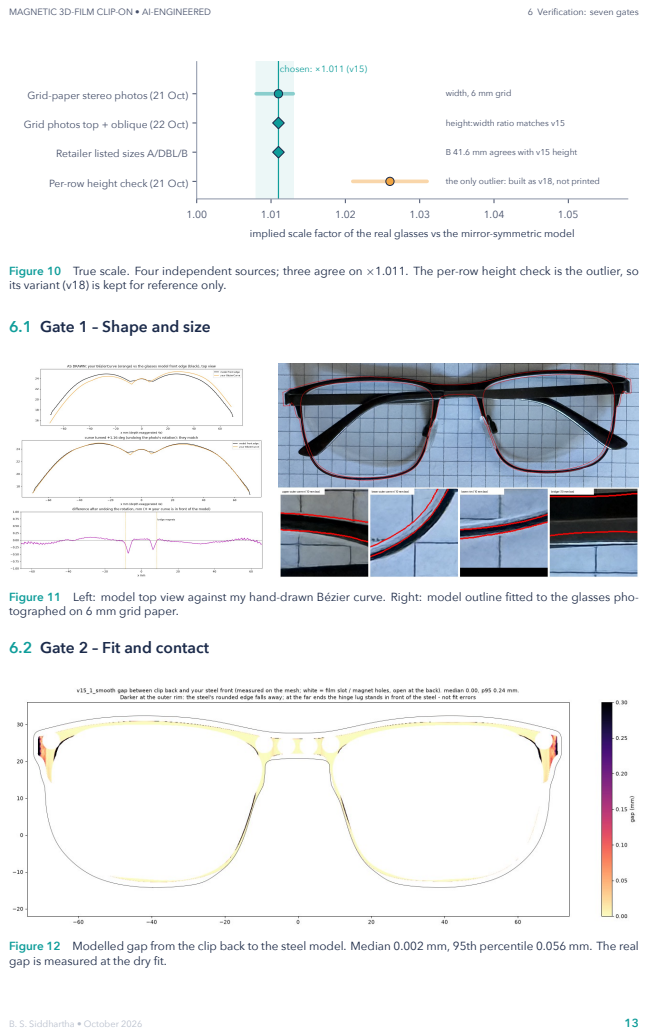
[picture p45: page 13]
MAGNETIC 3D-FILM CLIP-ON • AI-ENGINEERED; 6 Verification: seven gates; chosen: ×1.011 (v15); B. S. Siddhartha • October 2026

Grid-paper stereo photos (21 Oct)

width, 6 mm grid

Grid photos top + oblique (22 Oct)

height:width ratio matches v15

Retailer listed sizes A/DBL/B

B 41.6 mm agrees with v15 height

Per-row height check (21 Oct)

the only outlier: built as v18, not printed

implied scale factor of the real glasses vs the mirror-symmetric model

Figure 10 True scale. Four independent sources; three agree on ×1.011. The per-row height check is the outlier, so
its variant (v18) is kept for reference only.
6.1 Gate 1 – Shape and size

Figure 11 Left: model top view against my hand-drawn Bézier curve. Right: model outline fitted to the glasses pho-
tographed on 6 mm grid paper.
6.2 Gate 2 – Fit and contact

Figure 12 Modelled gap from the clip back to the steel model. Median 0.002 mm, 95th percentile 0.056 mm. The real
gap is measured at the dry fit.

MAGNETIC 3D-FILM CLIP-ON • AI-ENGINEERED | 6 Verification: seven gates

## 6.3 Gate 3 – Magnets


Figure 13 Six pockets: four at the bridge, two at the outer corners. Right: sections through each pocket; magnet face 0.08–0.16 mm from the steel, wall ≥ 0.997 mm, front cover ≥ 1.183 mm.

## 6.4 Gate 4 – Strength

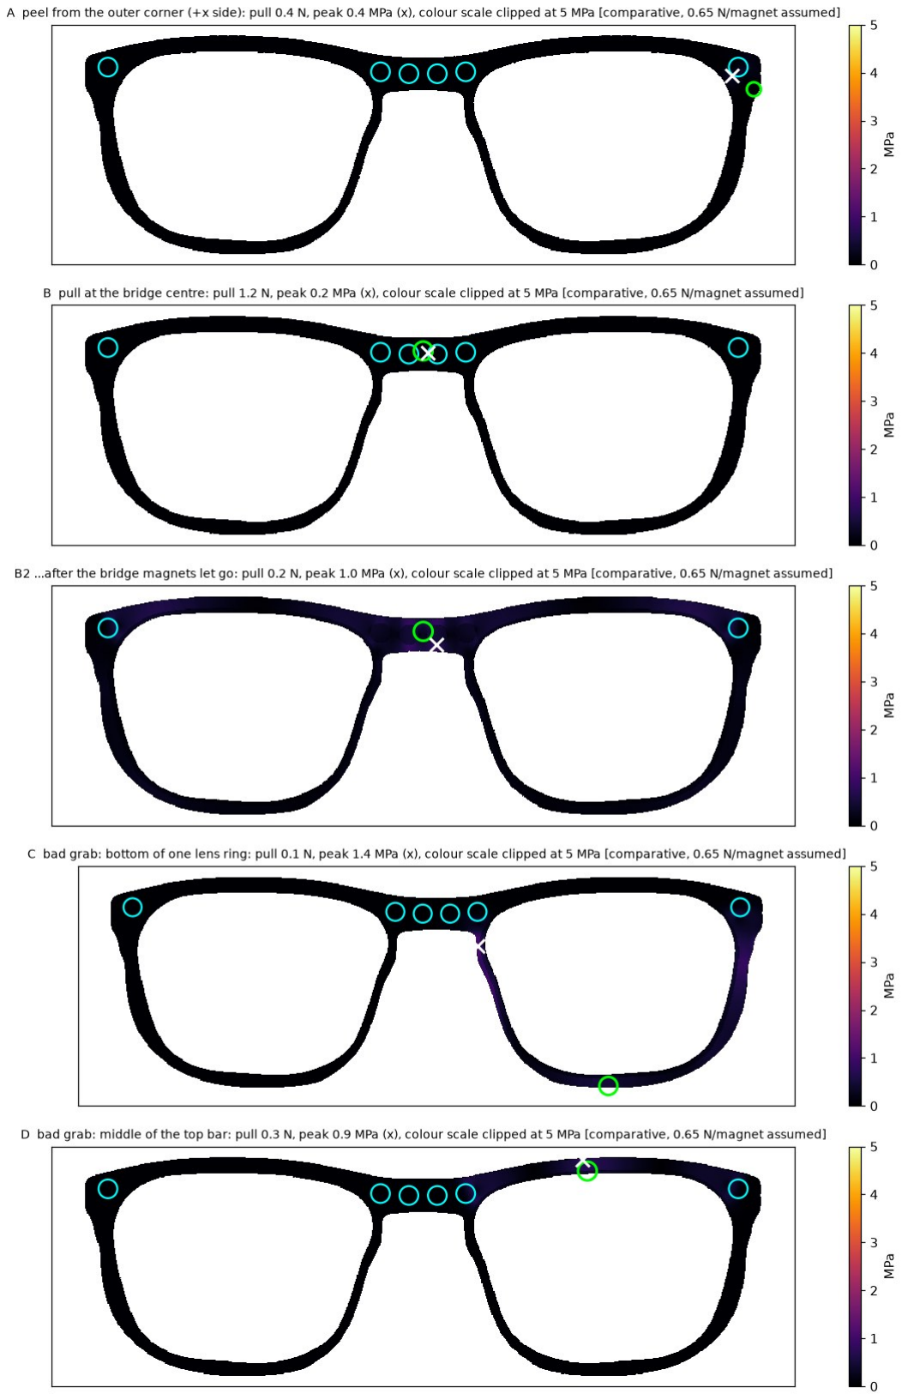
[picture p46: figure]
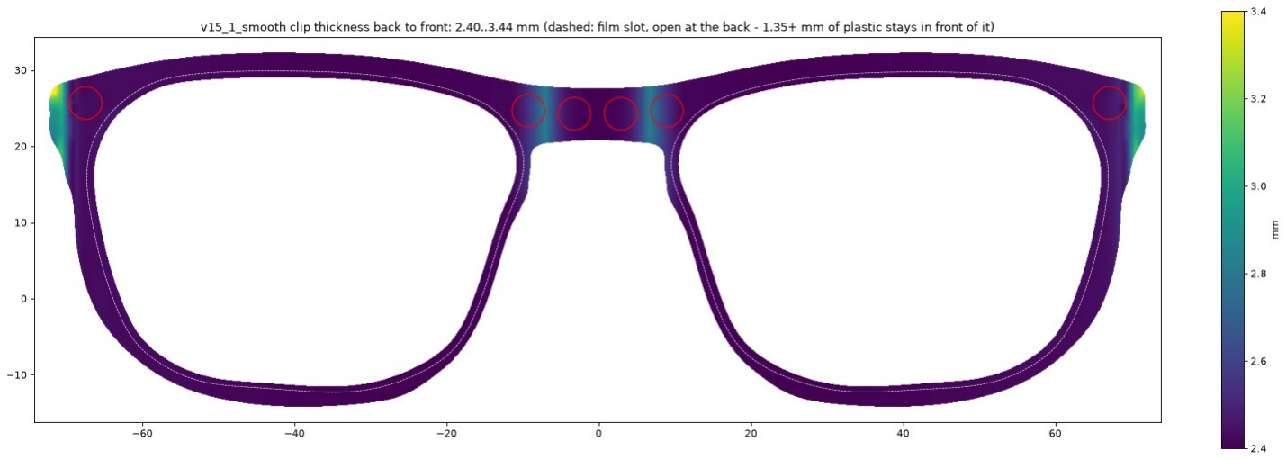
[picture p47: figure]

Figure 14 Plate-model FEA with one-way steel contact and five removal cases (peak 1.4 MPa in the worst grab), and the wall-thickness map. Comparative, not absolute.

## 6.5 Gate 5 – Film loading


Figure 15 The film is bowed about 7 mm in the middle, set in from the back and snaps flat. The sweep checks every intermediate state: minimum clearance 0.056 mm, peak bending strain 0.898% against an assumed 1% limit (the film’s real limit is unknown).

B. S. Siddhartha • October 2026 | 14

MAGNETIC 3D-FILM CLIP-ON • AI-ENGINEERED | 6 Verification: seven gates

## 6.6 Gate 6 – View and comfort


Figure 16 Left: what the eye sees through both lenses. Right: a face fitted to my photo’s proportions; 5,948 nose variants tested, none touch; the cheek gap below the lower rims is the one to watch (my photo itself stays private).

B. S. Siddhartha • October 2026 | 15

## 6.7 Gate 7 – Printability

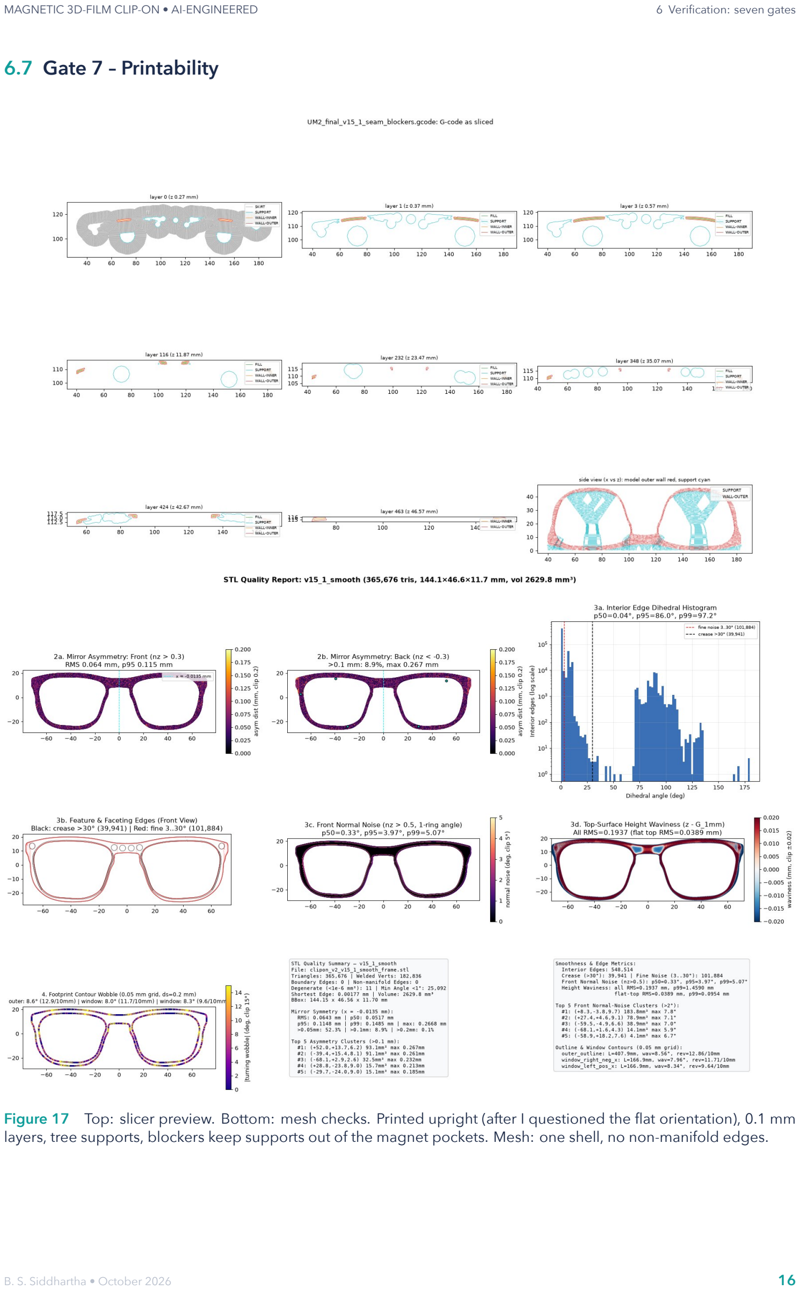
[picture p48: page 16]

MAGNETIC 3D-FILM CLIP-ON • AI-ENGINEERED | 6 Verification: seven gates

Figure 17 Top: slicer preview. Bottom: mesh checks. Printed upright (after I questioned the flat orientation), 0.1 mm layers, tree supports, blockers keep supports out of the magnet pockets. Mesh: one shell, no non-manifold edges.

B. S. Siddhartha • October 2026 | 16

MAGNETIC 3D-FILM CLIP-ON • AI-ENGINEERED | 7 The final design

# 7 The final design

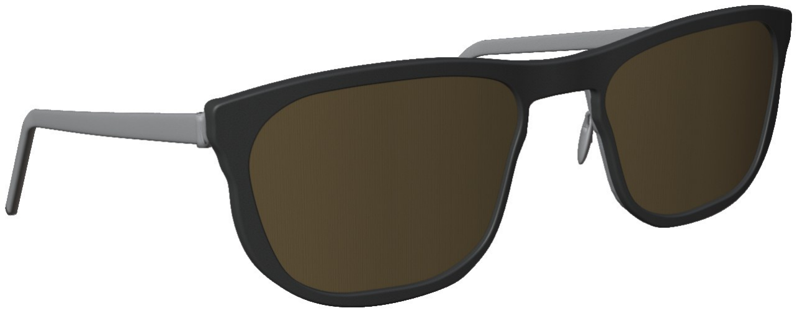
[picture p49: figure]
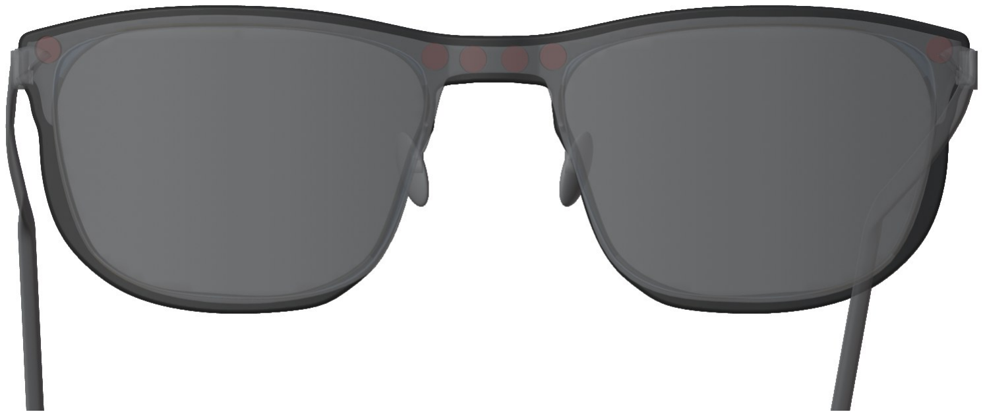
[picture p50: figure]

Figure 18 v15.1 on the glasses model: three-quarter view, back with the six pockets, x-ray of the film in its slot, and the design layout.

Clip | 144.15 mm wide, 3.26 g PLA (4.90 g with film and magnets), one piece
Magnets | 6 × Ø4 × 1 mm NdFeB discs (172 g rated pull each), epoxied, 0.1 mm below the back surface
Film | 0.2 mm polarised sheets from cinema 3D glasses, loaded from the back into a 0.4 mm slot held by lips; 1:1
| smooth cut template
View | front window leaves 97.4% of the model lens clear (about 95.5% of the photo-traced lens)
Print | Ultimaker 2+, PLA, 0.27 mm first layer then 0.1 mm, 100% infill, 8 mm brim, tree supports, 2 h 9 min, 7.3 g
| with supports
Assembly dry fit with loose magnets → epoxy (24 h cure) → cut film → bow-and-snap loading
B. S. Siddhartha • October 2026 | 17

MAGNETIC 3D-FILM CLIP-ON • AI-ENGINEERED | 8 Open items and field results

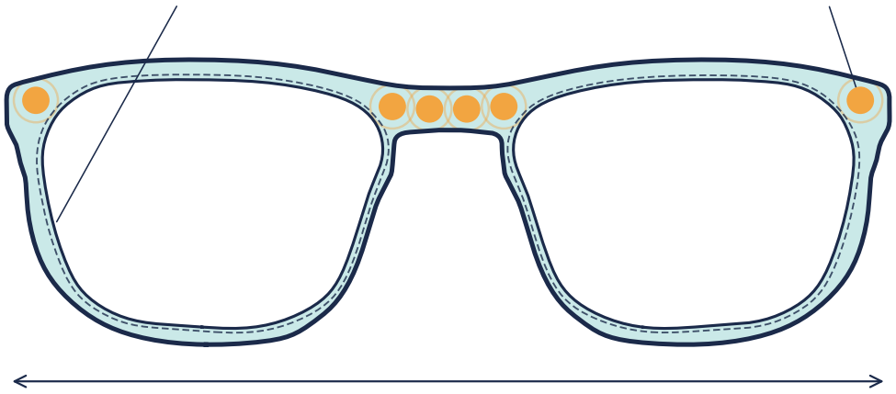
[picture p51: figure]

144.15 mm

0.2 mm film in a 0.4 mm back-loaded slot (dashed) | 6 × Ø4×1 mm NdFeB, epoxied in blind rear pockets

Figure 19 v15.1 drawn from the design data: clip outline, front windows, film groove and the six magnet positions.

# 8 Open items and field results

Not verified yet. The real pull per magnet on the thin rims; whether the front curve matches the model (the dry fit shows both); the lower-temple corners, where photos suggest the lens edge may stand up to 0.17 mm proud of the model; the true film thickness (0.2 mm assumed).

v Reserved: results after the print arrives. Dry-fit photos, paper-slip test at the corners and bridge, measured pull per magnet, first movie-night verdict, and any changes made as a result.

B. S. Siddhartha • October 2026 | 18

MAGNETIC 3D-FILM CLIP-ON • AI-ENGINEERED | 9 Before you start

# PART II

# Community playbook: build one for your glasses

# 9 Before you start

This is the procedure I propose, not the only way. My project took 21 versions because I was discovering the problems. With the rules and prompts below you should need far fewer. Budget a few evenings, and do not print until every check you can see passes.

## 9.1 Prerequisites

What you need | Why
Glasses | Your prescription glasses. Steel front → magnetic route; plastic, titanium
or rimless → clamp route. Test with any fridge magnet.

decides the grip

Film | One pair of passive (polarised) cinema 3D glasses. Do not swap left and
right.

the optics

Photos | Front, top and side photos as square-on as possible, plus the glasses on
grid paper with a coin. Use a longer lens or zoom to reduce perspective.

shape and true scale

Outlines | Trace the front outline and the top curve yourself (Blender curve or on
paper).

shape truth

Software | Blender (free), Python 3, an AI coding agent that can run Blender head-
less, a slicer (Cura).

build and check

Hardware | 3D printer access (0.4 mm nozzle, 0.1 mm layers), PLA or PETG; calipers
or a ruler; craft knife; 2-part epoxy.

make it

Magnets | (magnetic route) Ø4×1 mm N52 discs, about 10 (6 used); 2-part epoxy
only.

hold

Time | 3–6 evenings for the design; 2–3 h print; 24 h epoxy cure.
B. S. Siddhartha • October 2026 | 19

MAGNETIC 3D-FILM CLIP-ON • AI-ENGINEERED | 10 The procedure in ten steps

## 9.2 Which route?

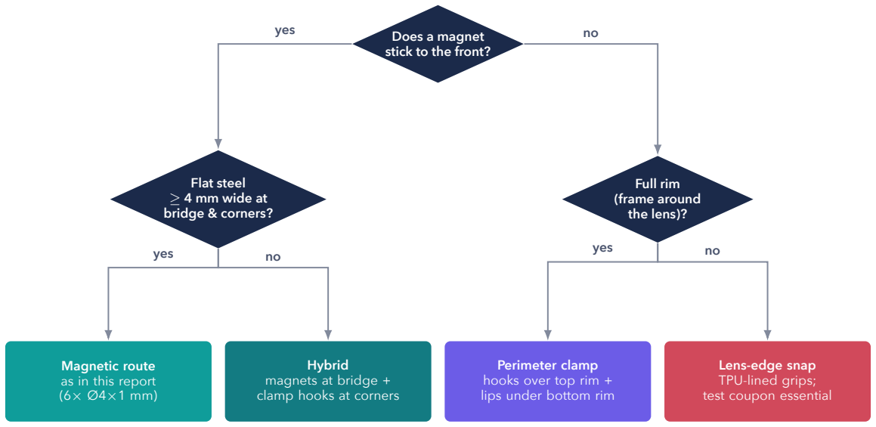
[picture p52: figure]
Does a magnet stick to the front?; Flat steel ≥ 4 mm wide at bridge & corners?; Full rim (frame around the lens)?; Magnetic route as in this report (6× Ø4×1 mm); Hybrid magnets at bridge + clamp hooks at corners; Perimeter clamp hooks over top rim + lips under bottom rim; Lens-edge snap TPU-lined grips; test coupon essential; yes

# 10 The procedure in ten steps

1. Photograph the glasses front, top and side, square on, on a plain background; then on grid paper with a known coin.
2. Trace the outlines yourself: front outline and top curve. Declare them the only source of shape.
3. Build the glasses model from the photos on three axes. Ask for overlays and an alignment number; allow 1–2◦ photo tilt correction. Make it mirror-symmetric if your frame is.
4. Prove the true scale from at least two independent sources (grid, coin, the size printed on the temple, e.g. 57 20-145). Do not continue until they agree.
5. Design the clip: outline flush with the frame, film slot from the back, magnet pockets square to the steel (or clamp hooks), smooth curves only.
6. Run the gates: shape, contact gap, magnet seating, strength, film loading, view, face comfort, printability. Ask for the plots, not a summary.
7. Print a test coupon of the bridge and one corner first (minutes of print time) and try it on the real glasses.
8. Print upright with supports kept out of the pockets; 0.1 mm layers.
9. Dry fit with loose magnets: no rocking; printer paper must not slide under the magnet spots.
10. Assemble: epoxy the magnets (never super glue), cure 24 h, cut the film with the 1:1 template, bow and snap it in from the back.
B. S. Siddhartha • October 2026 | 20

MAGNETIC 3D-FILM CLIP-ON • AI-ENGINEERED | 11 Prompt pack

# 11 Prompt pack

These are distilled from my own prompts. Replace <...>. The full set, including the non-metal clamp prompts,
is in prompts/PROMPT_PLAYBOOK.md.

P1 • Set the rules first (send once, at the start)

I am designing a 3D-printed clip-on that holds flat polarised 3D-cinema film in front of my prescription glasses (<frame type>). Rules for the whole project: (1) Shape comes ONLY from my hand-drawn outlines <files>; photos set size, never shape. (2) Never modify my original objects or files; build each version in its own folder with a report. (3) I have one chance to print: never present a design with a defect your own analysis shows. (4) Every claim needs evidence: a number, a plot or a section view. (5) The film can bend in one direction, never dome. (6) No CA/super glue near the film.

P2 • Build the glasses model from photos

Open <file>.blend. It has three reference photos (front, top, side) and my outlines. Build my glasses in 3D from the photos on all three axes, not from any scan. My photos may be 1-2 degrees off square; you may rotate the images to align. Show overlays of the model on each photo and report the alignment error in mm. The front must be exact because I will attach to it.

P3 • Prove the true scale

Here are photos of my glasses on <6 mm> grid paper with a <coin name> and the temple marking <57[]20-145>. Look up the coin's exact diameter. Measure the model's scale from each source separately, show the overlays, and tell me whether they agree. If one source disagrees, show me why before choosing. I want precision like 2.345 mm, not "about right".

P4 • Magnet layout I can judge myself

I have <N> magnets of <4 x 1 mm, rated pull 172 g on 10 mm steel>. Account for vertical mounting, thin steel and air gap. Show a front view of the frame with a colour gradient for depth and flatness, and mark where a magnet keeps full contact. Show me where you place each magnet; I will mark where I would put them and you explain why not.

P5 • Independent review with lenses

Give the model, my full request history and the rules to <2-3> other models. Each reviews through one lens: (a) making and using the real part, (b) smoothness and print quality, (c) accuracy against my outlines. Findings must cite a number, a file line or a render region. Verify each finding yourself; change the design only if it is real and serves my goal.

P6 • Final audit before printing

Before I print: list every check (fit, contact, magnets, strength, film loading, view, comfort, printability, size) with the number, the threshold and the plot. List what is NOT verified. Do not say ready unless every visible issue is fixed.

B. S. Siddhartha • October 2026 | 21

MAGNETIC 3D-FILM CLIP-ON • AI-ENGINEERED | 13 Lessons for the community

# 12 If your frame is not magnetic: clamp from all sides

Plastic (acetate), titanium and many alloy frames do not attract magnets. The same pipeline works; only the grip changes. My recommendation is a perimeter clamp: small hooks over the top rim and lips under the bottom rim on both lenses, so the clip grips the frame from all sides at once. The load is shared by many small contacts, there is no single pressure point, and the clip self-centres. glasses rim

film

hook 0.6–1.0 mm

TPU / felt pad

section through top and bottom rim | grip points spread around both lenses

top hooks

bottom lips

side tabs

- Clearance: start at 0.15–0.3 mm per side and tune it with a printed coupon of one corner; plastic frames vary.
- Hooks: 0.6–1.0 mm deep, filleted at the root; print so layer lines run across the hook, not along it, or it will snap.
- Never press on the lens face or its coating; line contact points with thin TPU or felt.
- Keep clear of nose pads, hinges and the field of view; the gates (view, comfort) still apply.
- Full comparison of grip options, rules, prompts and checklists: guide/NON_METAL_FRAMES.md.

# 13 Lessons for the community

### 1. The model is the foundation. A third of my prompts went

into the glasses model. Every later error (gaps, spikes, scale) traced back to it.

### 2. AI confidence is not evidence. “Ready to print” was said

several times before it was true. Ask for the plot.

### 3. Read the datasheet yourself. Rated magnet pull assumes

thick horizontal steel; on a thin vertical rim expect a fraction of it.

### 4. Your own photos are measuring instruments. Grid paper

and a well-known coin beat any assumption about size.

### 5. Do not let photo noise into cut lines. Traced outlines

wiggle; anything you cut by hand should be a smooth curve.

### 6. Keep every version. A rejected variant is the proof of why

the final one is right (v16 and v18 saved me from two wrong prints).

### 7. Print a coupon. A bridge-and-corner coupon costs min-

utes and catches what no simulation can.

### 8. Safety. Never super glue near the film; never walk around

or drive wearing 3D film; stop if it presses on your nose or cheeks.

B. S. Siddhartha • October 2026 | 22

MAGNETIC 3D-FILM CLIP-ON • AI-ENGINEERED | B Reproducing the figures

# A Version ledger

Ver. | Idea | Why it was replaced | Status
v00 | glasses model from photos + outlines | refined → aligned → symmetric → ×1.011 | base
v01 | first clip, film uncut | film too big, protruded | superseded
v02 | film cut to lens outline | protruded towards the nose | superseded
v03 | clip never past the steel | magnets not chosen yet | superseded
v04 | flush, 4×1 mm magnets | cut too much film | superseded
v05 | wide clip, film almost uncut | border too weak | superseded
v06 | wider plastic border | magnet padding | superseded
v07 | magnets at my sketched spots | model drift found (two spikes) | superseded
v08 | first clip on the aligned model | visible gap, slanted holes | superseded
v09 | square pockets, smooth front | film loading method | superseded
v10 | film slot open at the back | film shape from real sheets | superseded
vX | ChatGPT/Codex side attempt | fictional film contour | rejected
v11 | film cut from the two real sheets | asymmetric, hold under-estimated | superseded
v12 | mirror-symmetric, 4 magnets | four magnets judged too few | superseded
v13 | six single magnets | bridge underside, review findings | superseded
v14 | faired bridge arch, comfort checks | size never proven | superseded
v15 | rebuilt at measured ×1.011 | wiggly film slot and cut | superseded
v16 | reshaped to a photo re-trace | broke the outline rule | rejected
v17 | film slot from photo re-trace | abandoned with v16 | abandoned
v18 | height ×1.026 | 1.3% too tall vs 3 of 4 sources | kept
v15.1 | smooth slot, lips and cut | – | FINAL

# B Reproducing the figures

Figures come from the private design workspace (Blender scenes and analysis scripts).
scripts/collect_figures.py copies them, scripts/make_charts.py draws the charts, and
scripts/curate_prompts.py produces the curated prompt log. Build this report with xelatex main.tex (twice).
B. S. Siddhartha • October 2026 | 23
