Siddhu-123/ai-designed-3d-glasses-clipon/files/film_template_example_A4.pdf

# wearer's RIGHT eye

# TOP ^

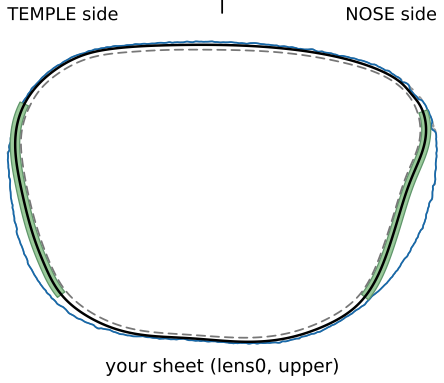
[picture p53: figure]
TEMPLE side; NOSE side; your sheet (lens0, upper)

CUT · what you see through the clip · lip sheet turned +92.7 deg from the photo, not flipped flat cut size 57.9 x 41.9 mm

# wearer's LEFT eye

# TOP ^

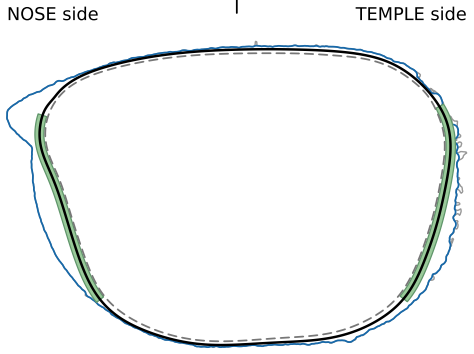
[picture p54: figure]
NOSE side; TEMPLE side

your sheet (lens1, lower, long nasal tab) CUT · what you see through the clip · lip sheet turned +87.4 deg from the photo, not flipped flat cut size 58.0 x 41.7 mm

50 mm - print at 100 % (no fit-to-page) and check

v15_1_smooth clip. Viewed from the FRONT of the glasses. Lay each sheet with the face that was UP in the photo facing you: that face is the outer (world) side, the other faces your eye.
Cut on the solid black line: it stays >= 0.08 mm inside your sheet. Film assumed ~0.2 mm thick.
Mark TOP on each film with a dot before cutting.

Print at 100 % / "Actual size" (no fit-to-page). The 50 mm bar must measure 50 mm.
