Siddhu-123/ai-designed-3d-glasses-clipon/docs/img/magnet_pockets_back.jpg

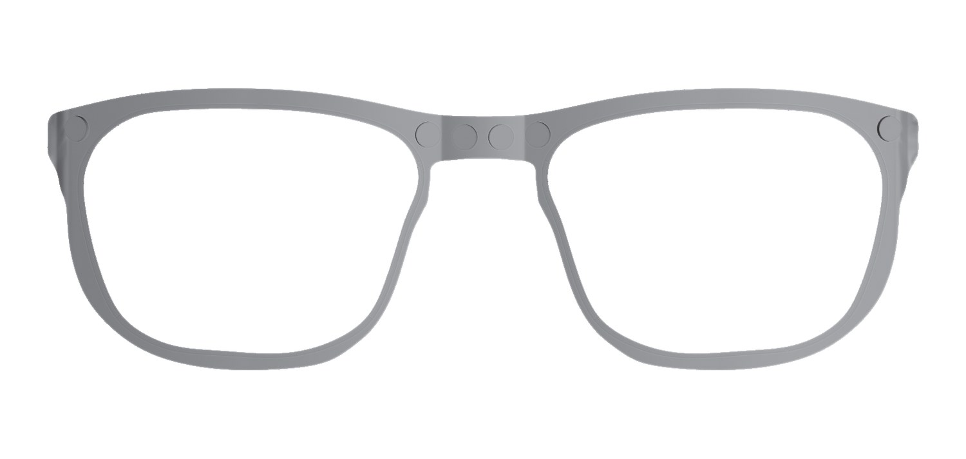
docs/img/magnet_pockets_back.jpg
