Siddhu-123/ai-designed-3d-glasses-clipon/report/figures/comfort_check.jpg

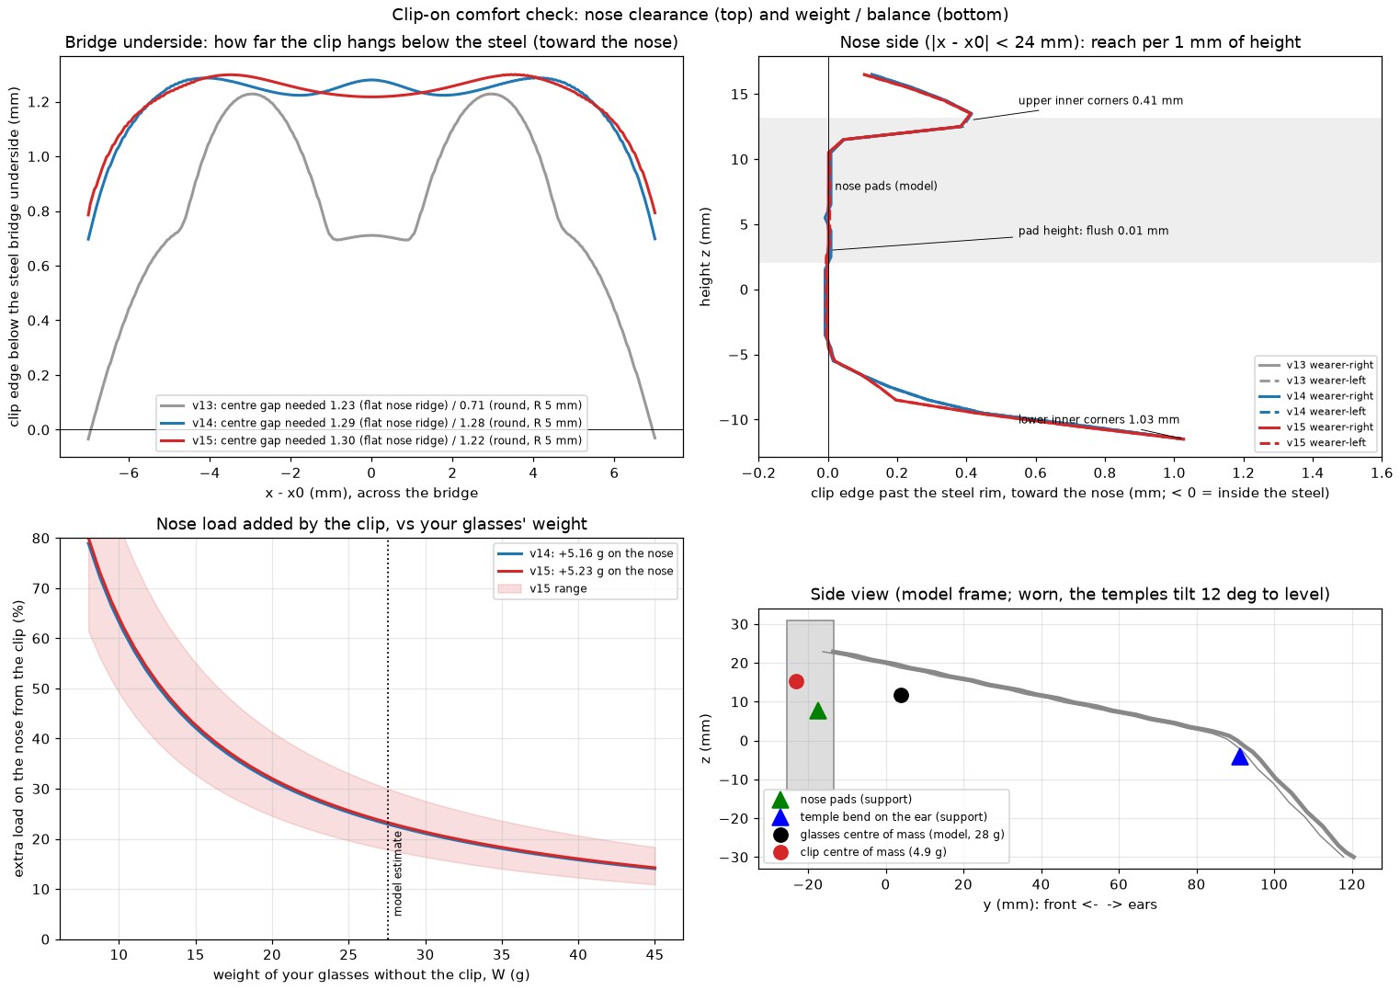
report/figures/comfort_check.jpg
