Siddhu-123/ai-designed-3d-glasses-clipon/report/figures/cura.jpg

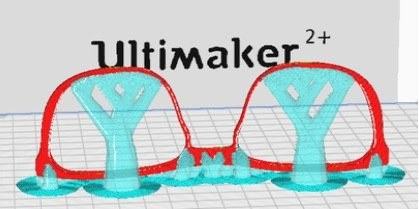
report/figures/cura.jpg
