Siddhu-123/ai-designed-3d-glasses-clipon/report/figures/face_front.jpg

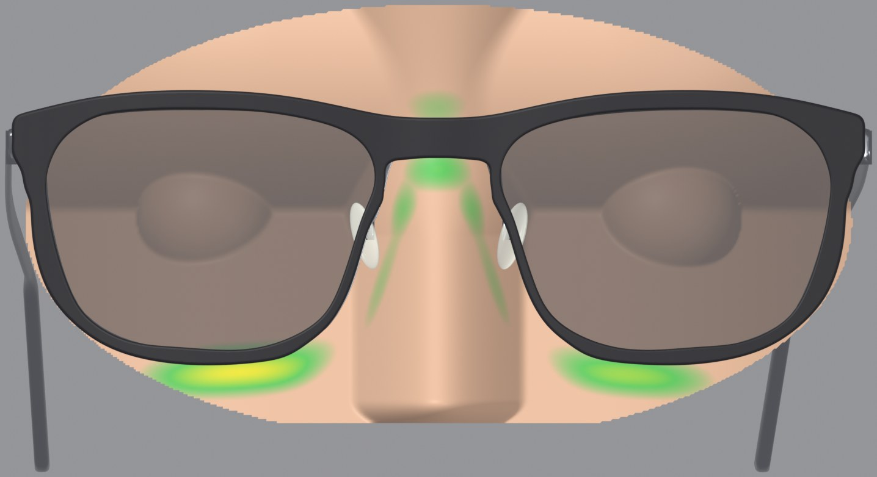
report/figures/face_front.jpg
