Siddhu-123/ai-designed-3d-glasses-clipon/report/figures/film_vs_lens.jpg

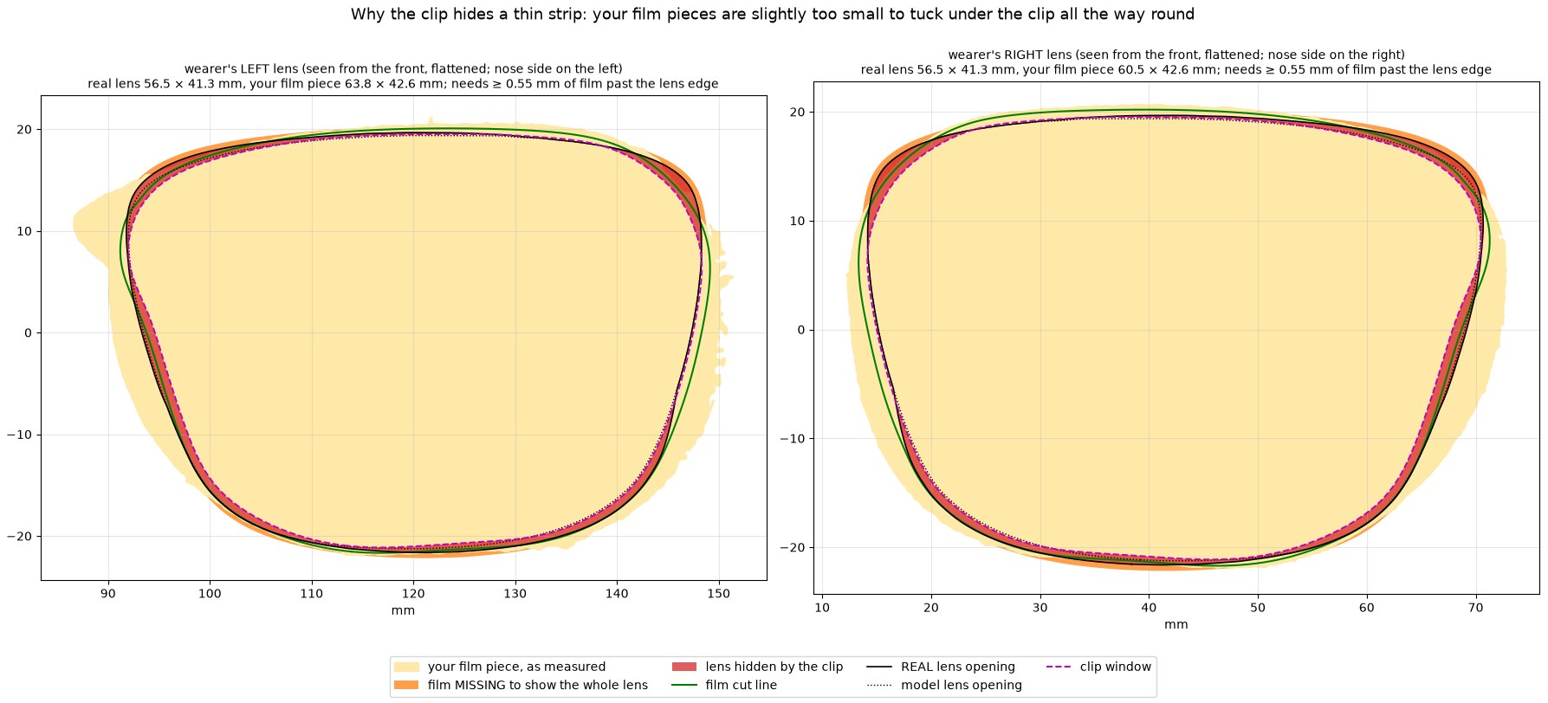
report/figures/film_vs_lens.jpg
