Siddhu-123/ai-designed-3d-glasses-clipon/report/figures/photo_top.jpg

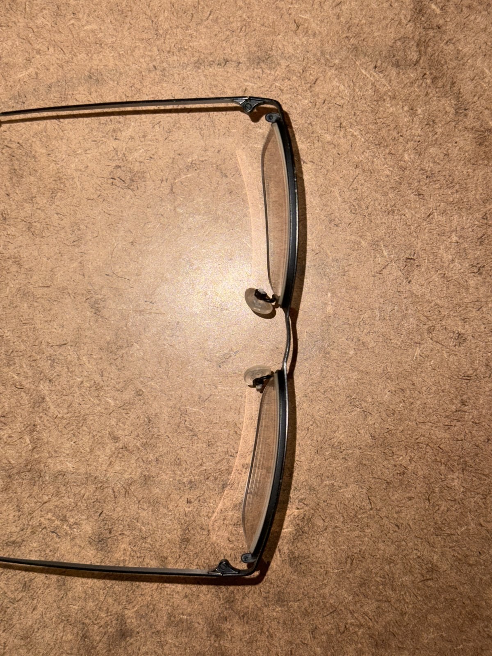
report/figures/photo_top.jpg
