Siddhu-123/ai-designed-3d-glasses-clipon/report/figures/photo_vs_model.jpg

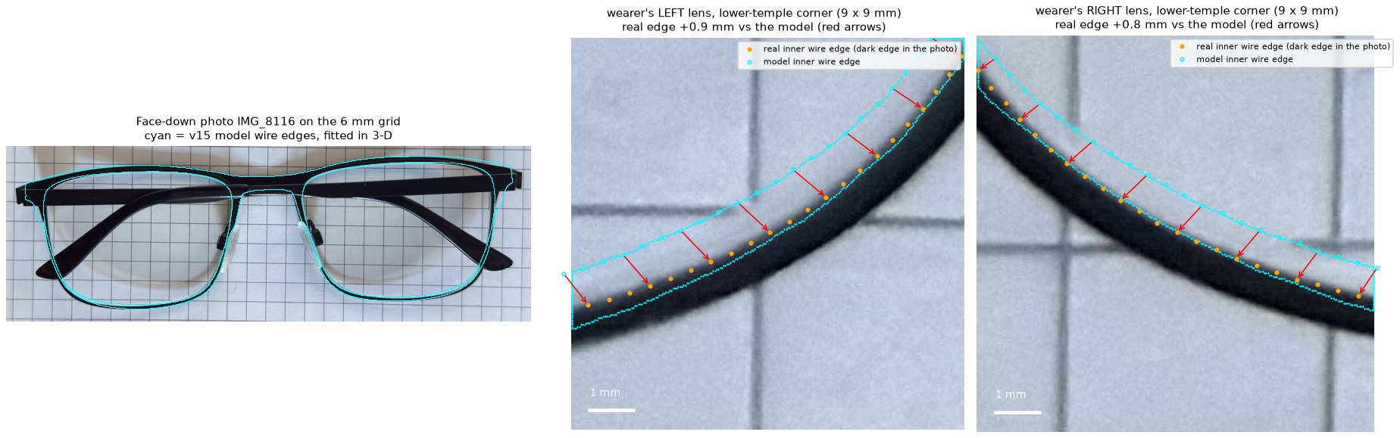
report/figures/photo_vs_model.jpg
