Siddhu-123/ai-designed-3d-glasses-clipon/report/figures/pull.jpg

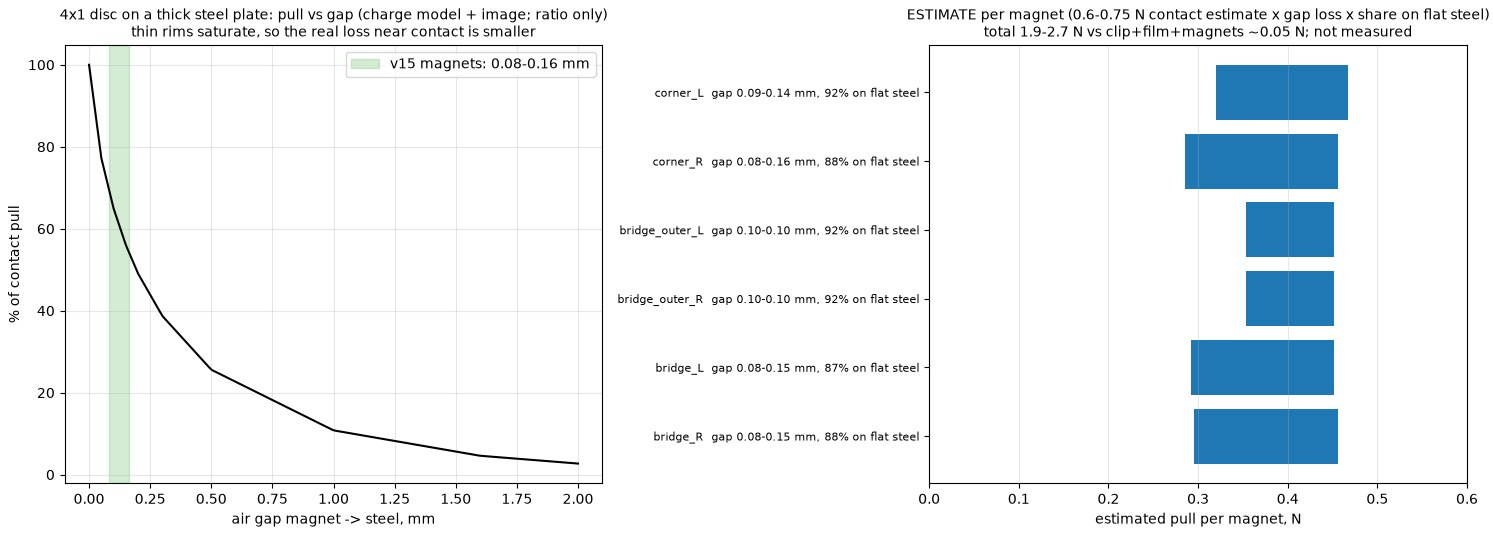
report/figures/pull.jpg
