Siddhu-123/ai-designed-3d-glasses-clipon/report/figures/render_back_bridge.jpg

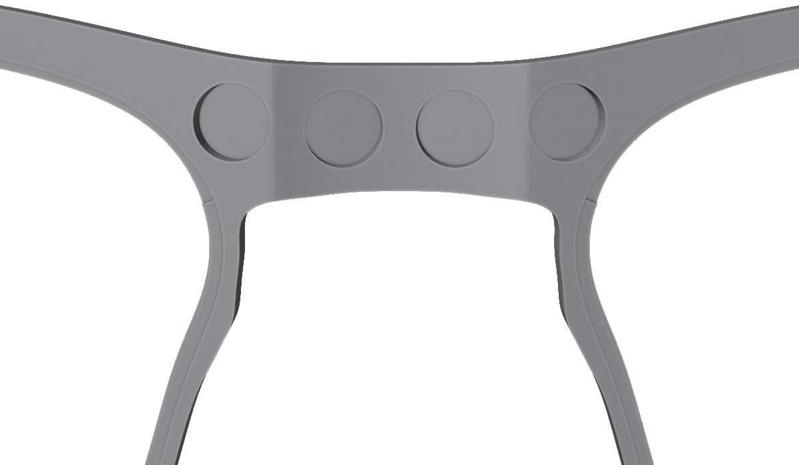
report/figures/render_back_bridge.jpg
