Siddhu-123/ai-designed-3d-glasses-clipon/report/figures/slot_sections.jpg

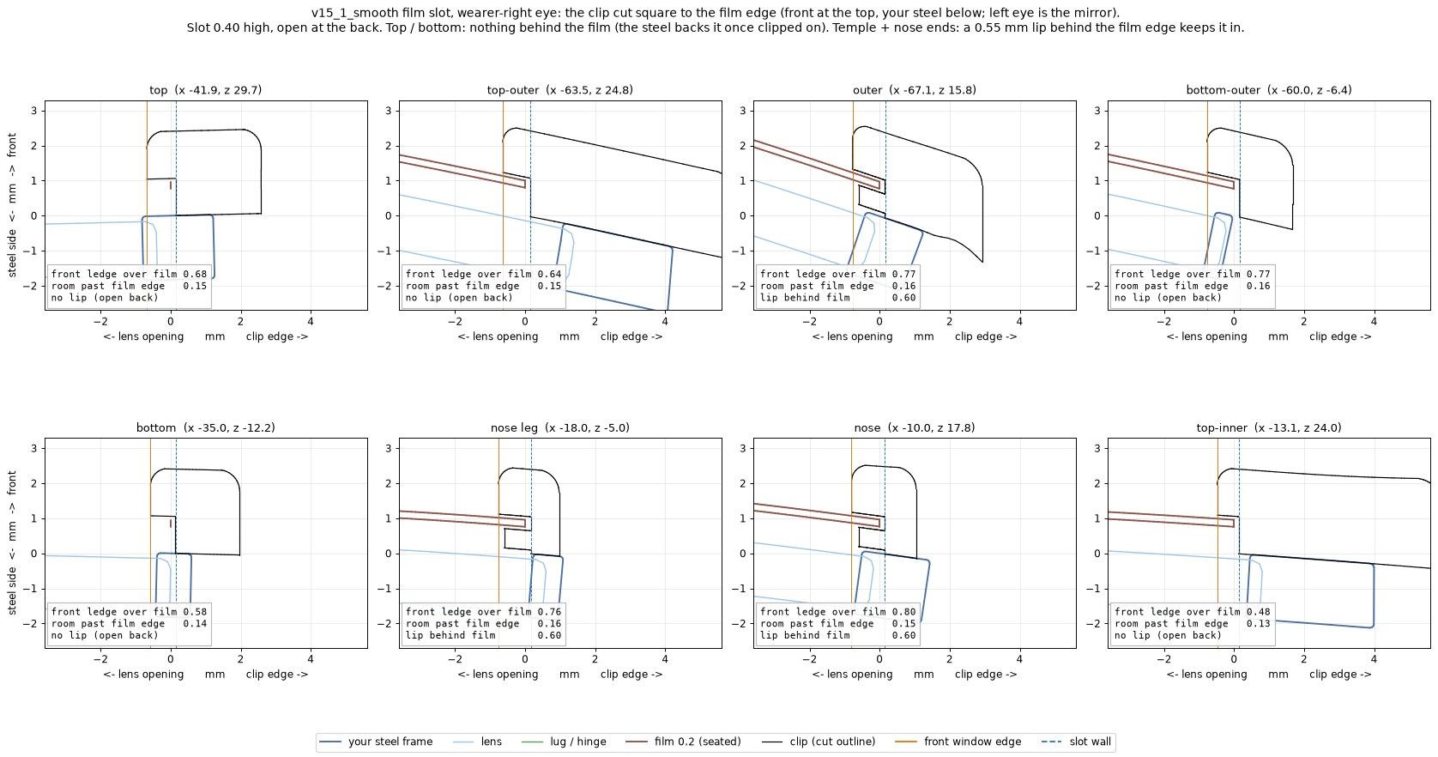
report/figures/slot_sections.jpg
