Siddhu-123/ai-designed-3d-glasses-clipon/report/figures/steel_flat.jpg

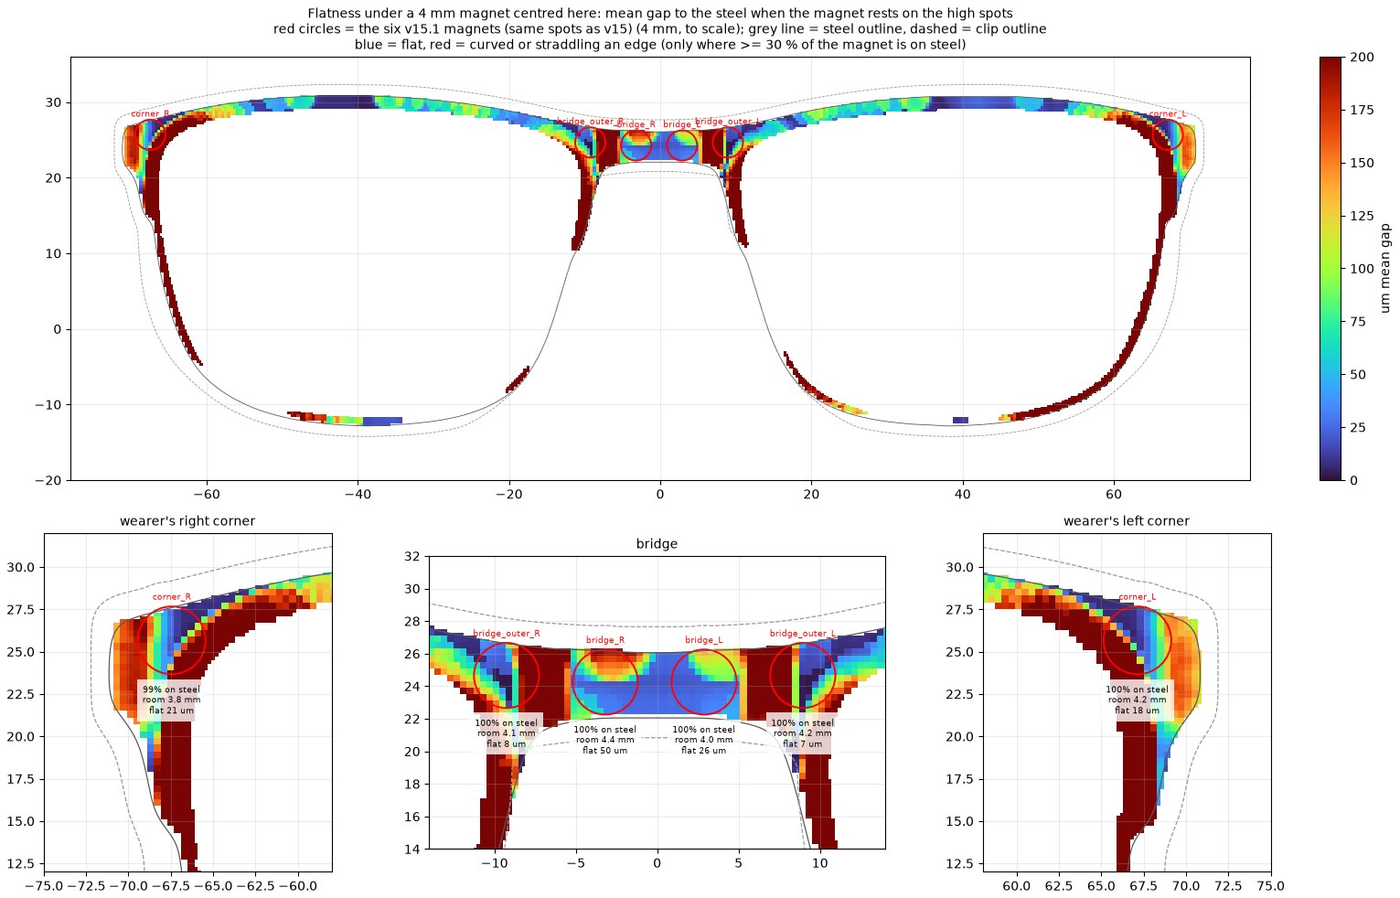
report/figures/steel_flat.jpg
