Siddhu-123/ai-designed-3d-glasses-clipon/report/figures/symmetry.jpg

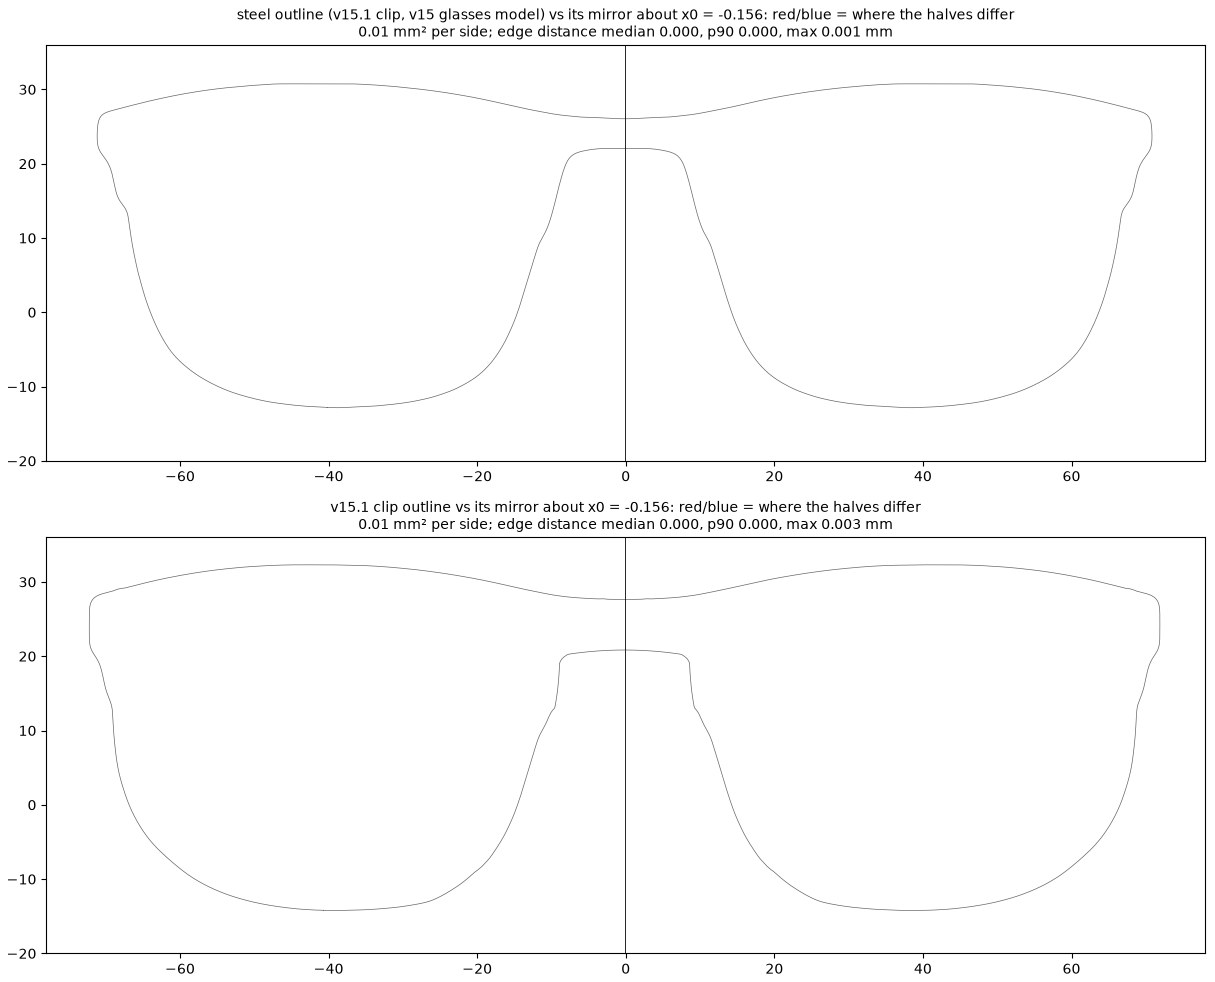
report/figures/symmetry.jpg
