Siddhu-123/ai-designed-3d-glasses-clipon/report/figures/template.jpg

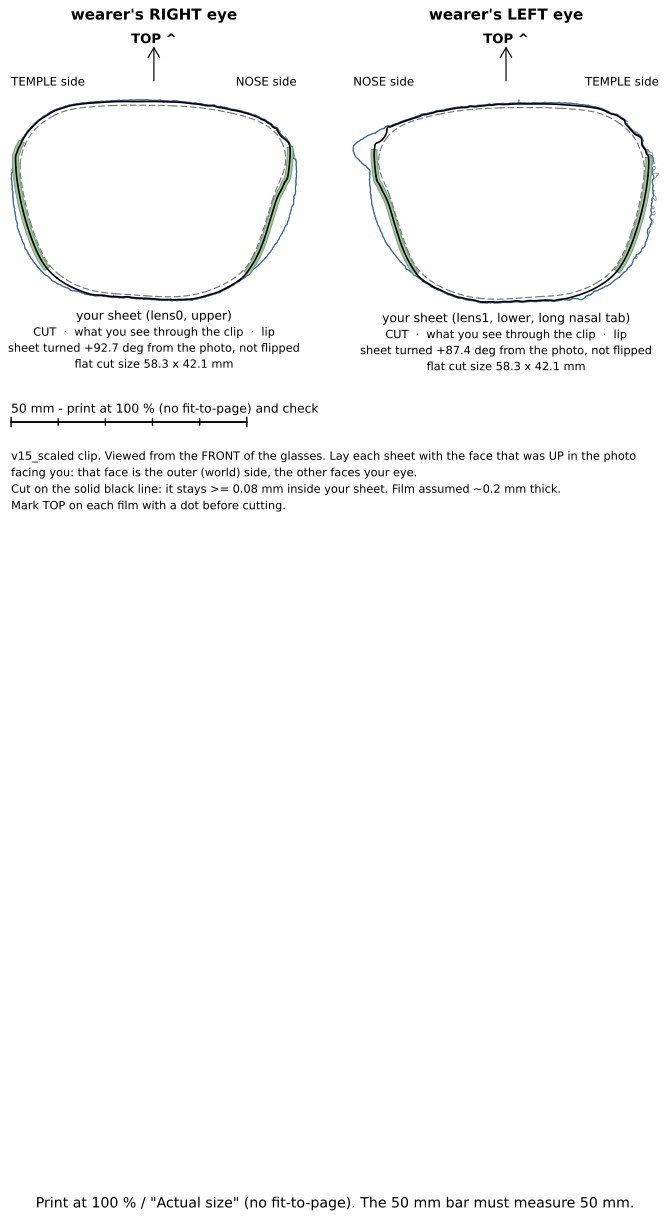
report/figures/template.jpg
