Siddhu-123/ai-designed-3d-glasses-clipon/files/clipon_v15_1_example.stl

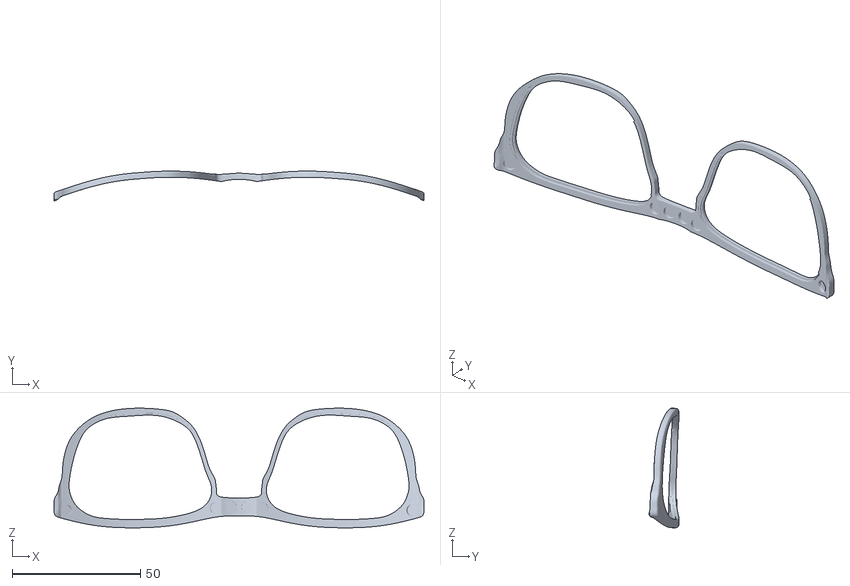
[picture p68: CAD file, 2026-10-27]
files/clipon_v15_1_example.stl
144.1 x 11.6 x 46.6
