Siddhu-123/ai-designed-3d-glasses-clipon/report/charts/version_changes.pdf

## v01 v02 v03 v04 v05 v06 v07 v08 v09 v10 v11 v12 v13 v14 v15 v16 v17 v18 v15.1

## Glasses model

## True scale

## Outline / border

## Film shape

## Film loading

## Magnet count / spots

## Pocket geometry

## Bridge / comfort

## Smooth curves

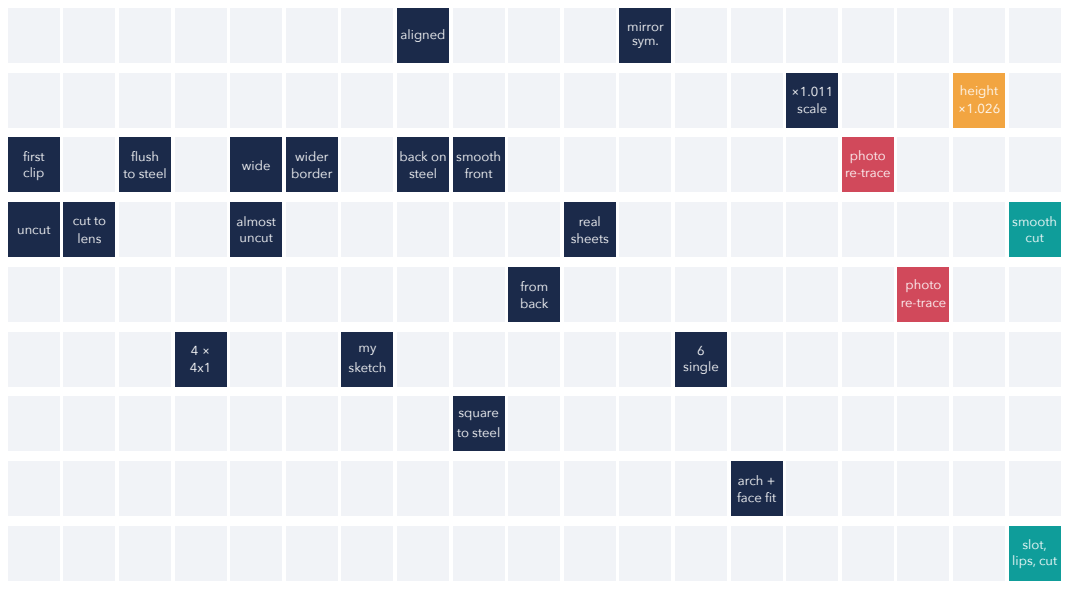
[picture p69: figure]
first clip; uncut; cut to lens; flush to steel; wide; almost uncut; wider border; my sketch; aligned; back on steel; smooth front; square to steel; from back; real sheets; mirror sym.; 6 single; arch + face fit; ×1.011 scale; photo re-trace; height ×1.026; smooth cut; slot, lips, cut

change kept | rejected / abandoned | kept, not for print | final
