Siddhu-123/ai-designed-3d-glasses-clipon/(commit log)

2026-10-27 LaTeX report, README, prompt playbook, non-metal guide, charts and figures
    Report (21 pages): story, principles, iteration journey, prompt anatomy,
    orchestration, seven verification gates, final design, community playbook.
    Prompt classification and NON_METAL_FRAMES.md drafted by codex/gpt-6.1-sol
    workers and checked by scripts/check_classes.py and check_nonmetal.py.
    [clipon_v15_1_example.stl]
2026-10-27 Report fix round: layout, version-change matrix, real-outline cover, full-size trimmed figures, corrected numbers
    - Contents on one page (tocdepth 2); decision tree redrawn with fixed coordinates
    - Prompt templates ragged-right instead of stretched monospace
    - Version-change matrix replaces the 16-render strip
    - Cover and blueprint drawn from the v15.1 design data
    - Analysis figures trimmed, markups contrast-boosted, gate figures as equal-height rows
    - Strain 0.898% vs an assumed 1% limit; 0.002 mm labelled as modelled; dropped the '~20 times' claim
2026-10-27 Report: numbers corrected after the 2026-10-27 audit
    Hold 1.9-2.7 N vs 0.048 N; 97.4 % is vs the model lens (95.5 % photo-traced);
    0.27 mm first layer then 0.1 mm. collect_figures.py paths follow the new
    blender_ai/frame/archive layout. PDF and charts rebuilt.
